anonymrobotic/artis/static/images/2-6.jpg

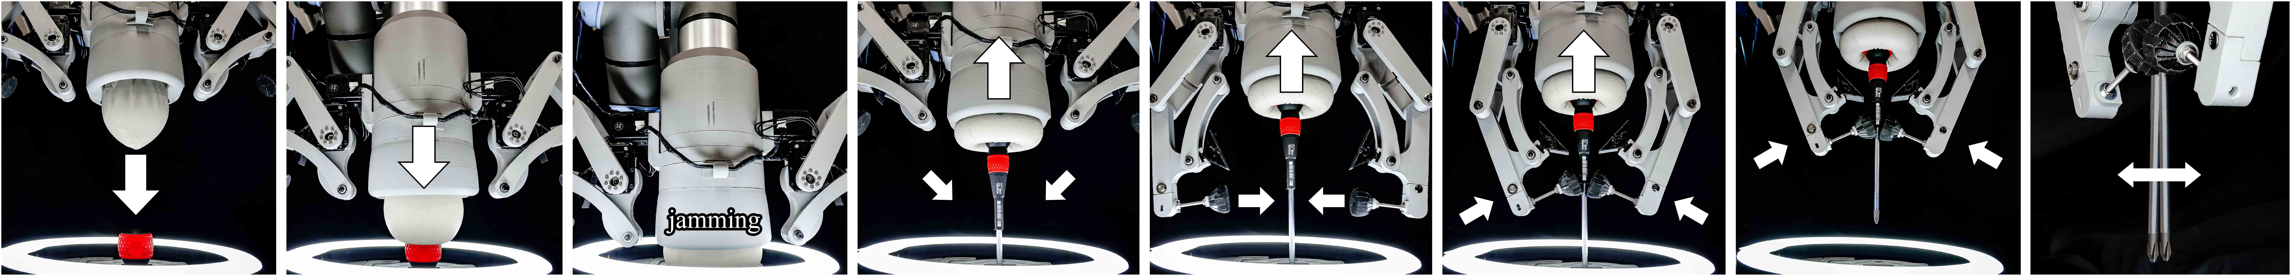
static/images/2-6.jpg
