anonymrobotic/artis/static/images/2F_1.jpg

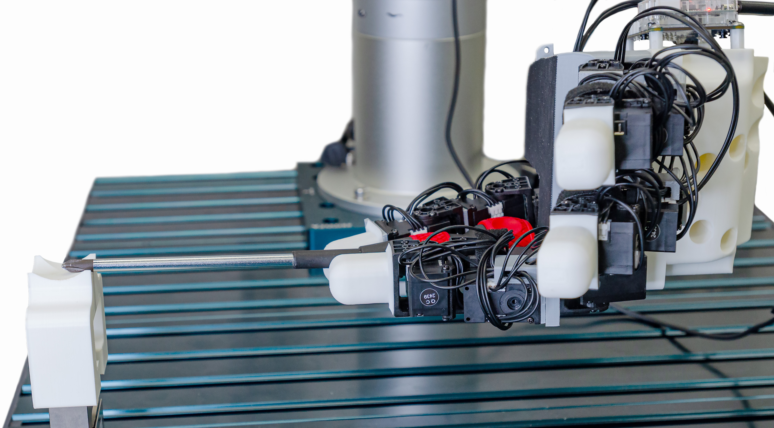
static/images/2F_1.jpg
