anonymrobotic/artis/static/images/3F_1.jpg

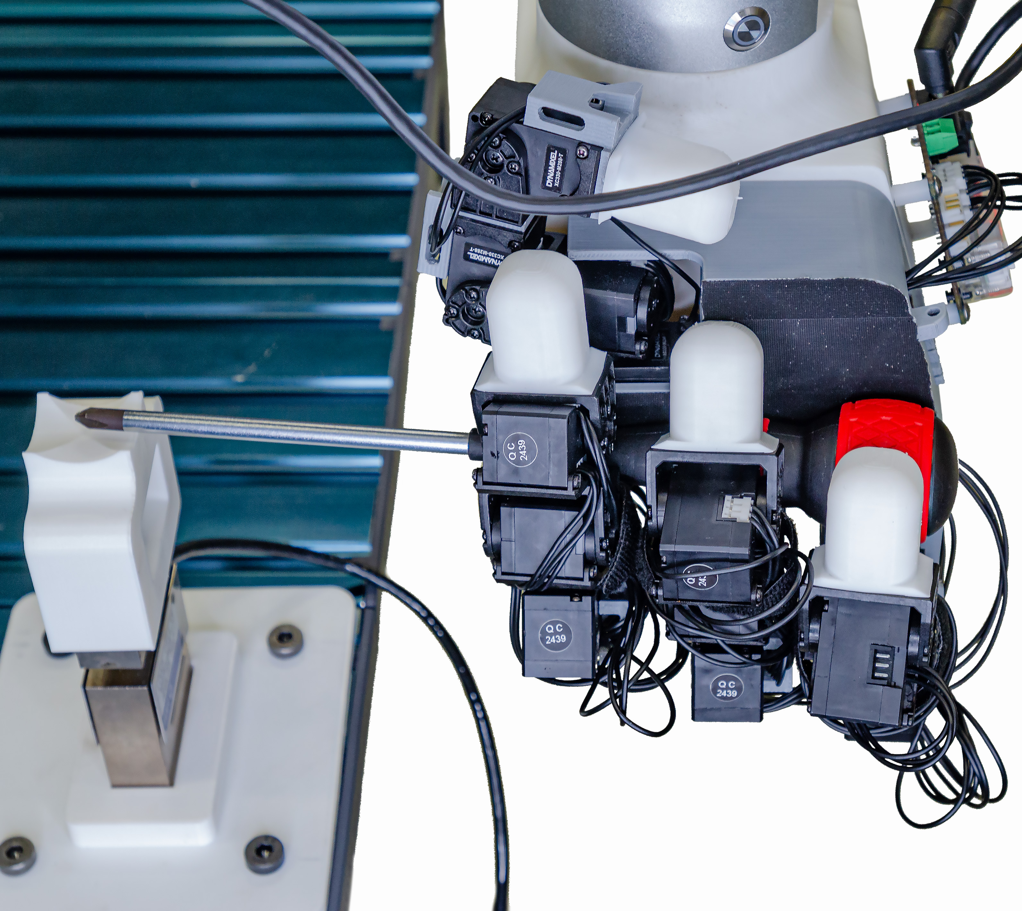
static/images/3F_1.jpg
