anonymrobotic/artis/static/images/Abstract_1.jpg

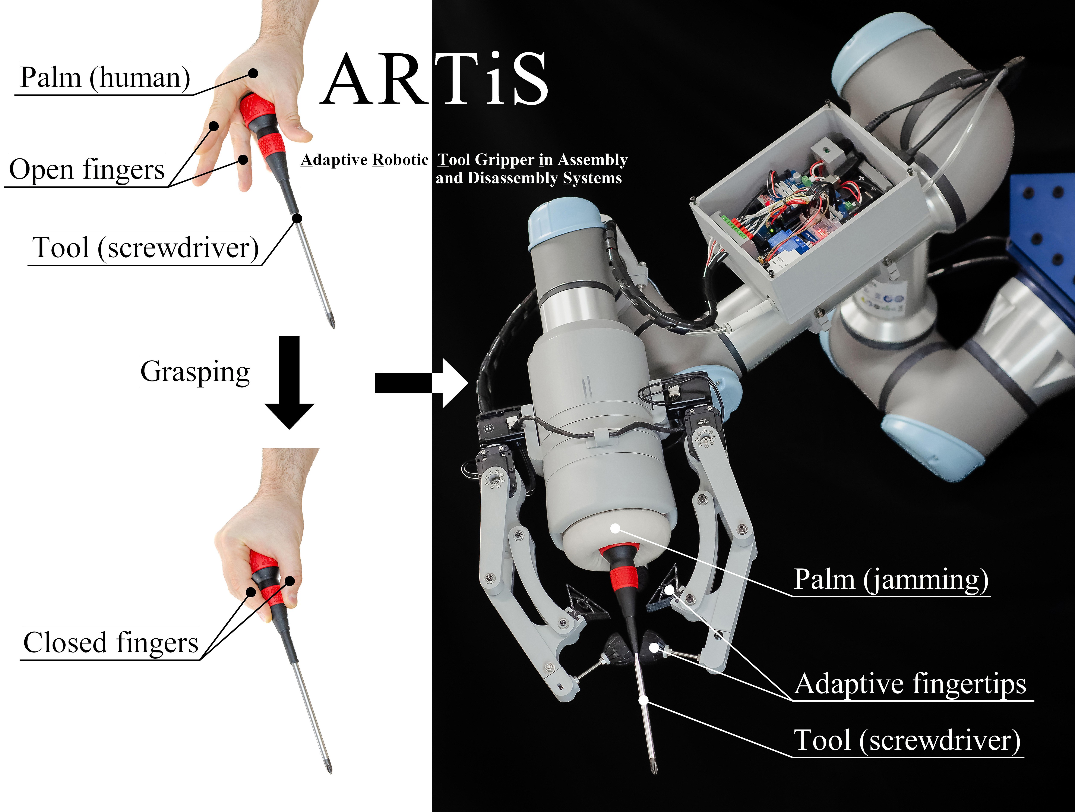
static/images/Abstract_1.jpg
