anonymrobotic/artis/static/images/AIST.jpg

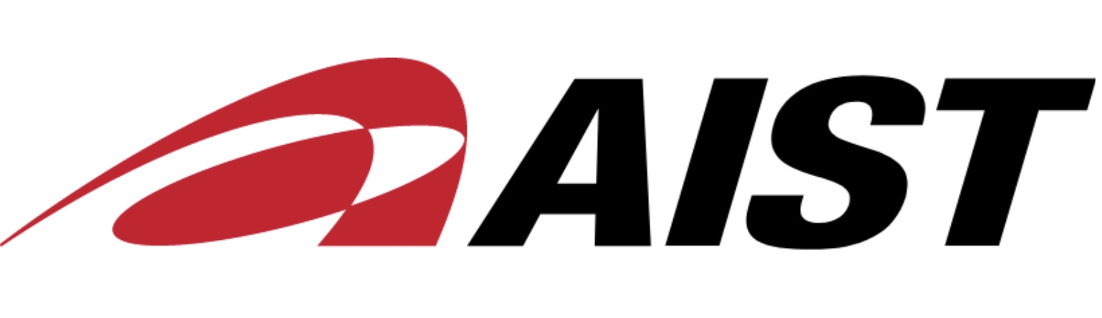
static/images/AIST.jpg
