anonymrobotic/artis/static/images/CAD/Axis_holder.jpg

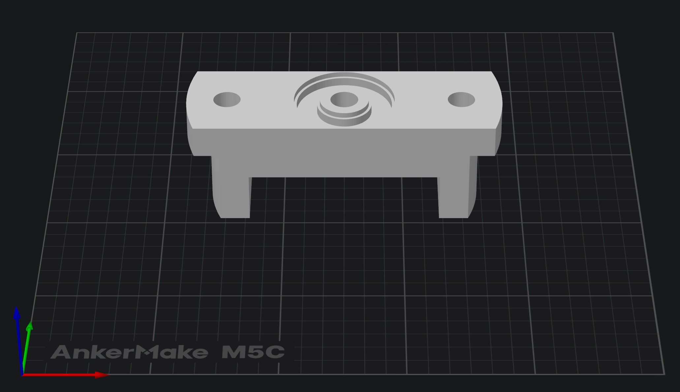
static/images/CAD/Axis_holder.jpg
