anonymrobotic/artis/static/images/CAD/Axle_lock.jpg

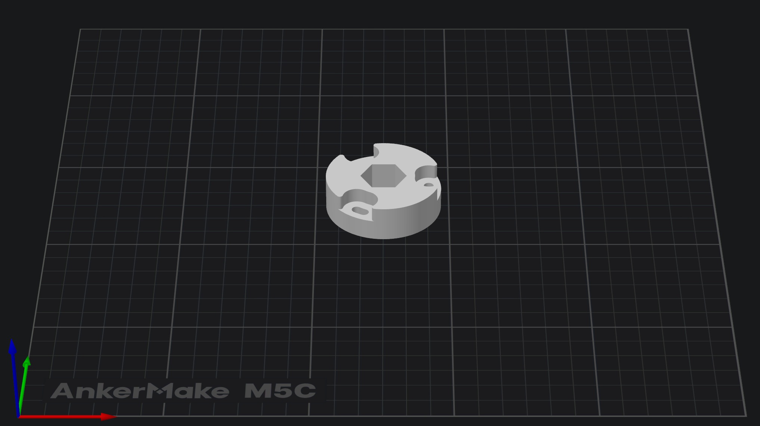
static/images/CAD/Axle_lock.jpg
