anonymrobotic/artis/static/images/CAD/Base1.jpg

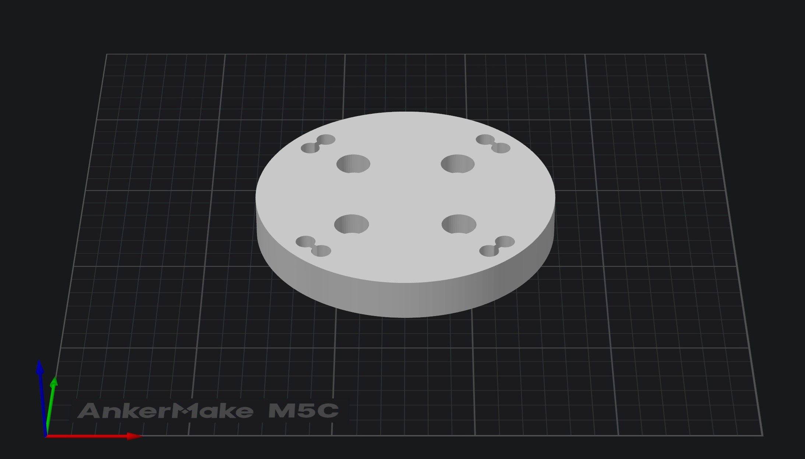
static/images/CAD/Base1.jpg
