anonymrobotic/artis/static/images/CAD/Base2.jpg

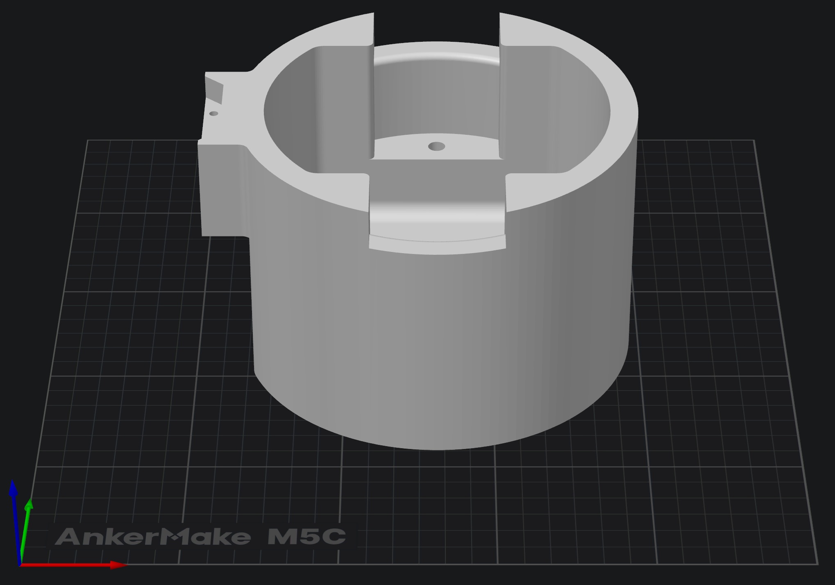
static/images/CAD/Base2.jpg
