anonymrobotic/artis/static/images/CAD/Box.jpg

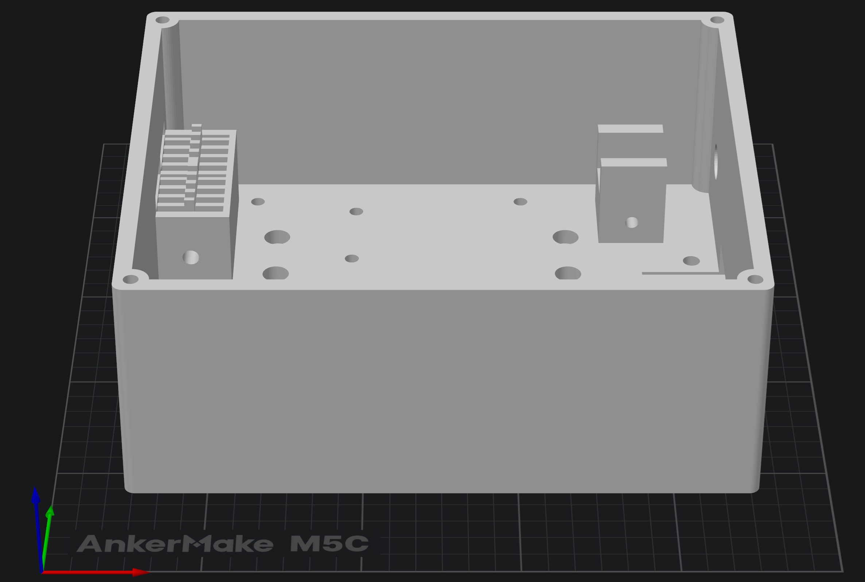
static/images/CAD/Box.jpg
