anonymrobotic/artis/static/images/CAD/Box_Holder.jpg

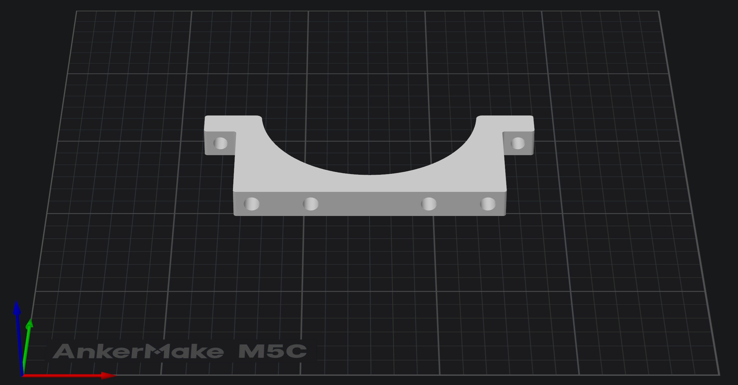
static/images/CAD/Box_Holder.jpg
