anonymrobotic/artis/static/images/CAD/Box_Holder_Bot.jpg

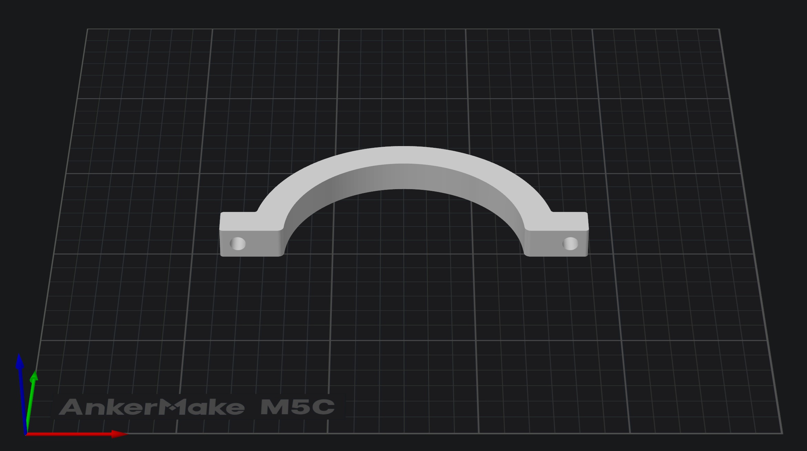
static/images/CAD/Box_Holder_Bot.jpg
