anonymrobotic/artis/static/images/CAD/Cable_retention.jpg

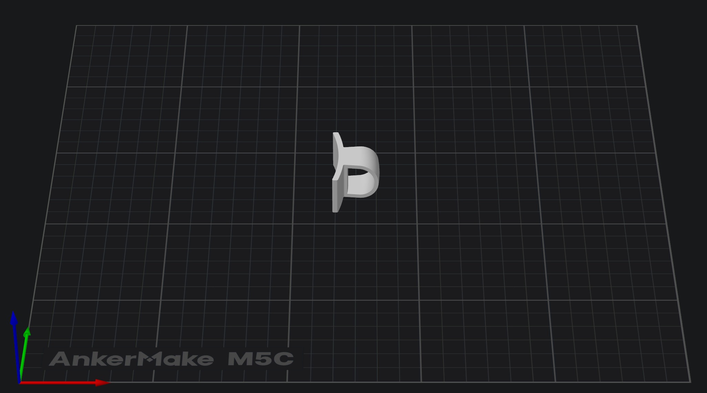
static/images/CAD/Cable_retention.jpg
