anonymrobotic/artis/static/images/CAD/Cup.jpg

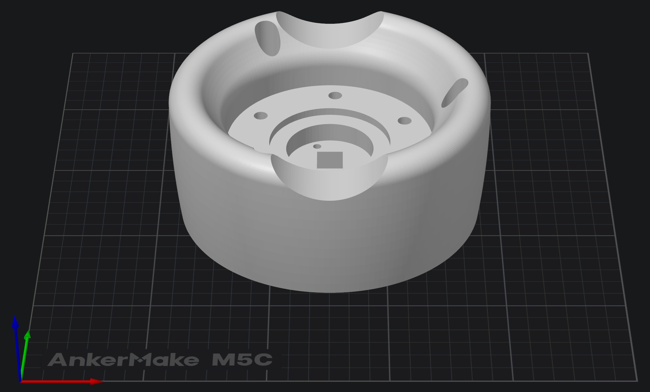
static/images/CAD/Cup.jpg
