anonymrobotic/artis/static/images/CAD/Fastener.jpg

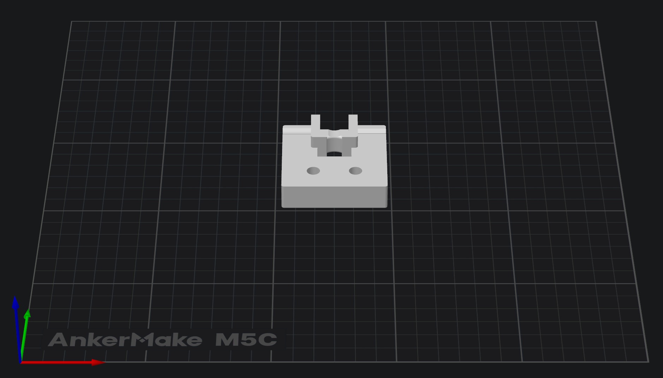
static/images/CAD/Fastener.jpg
