anonymrobotic/artis/static/images/CAD/Filter.jpg

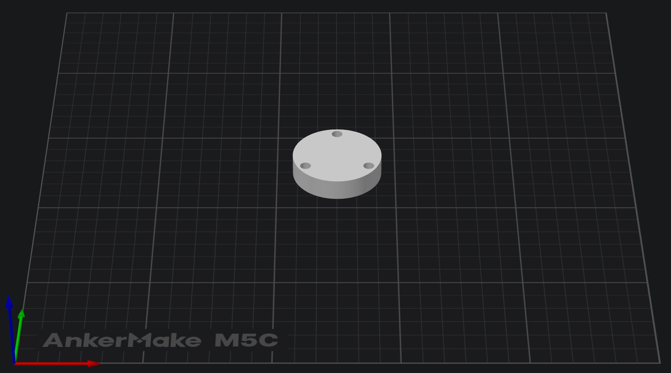
static/images/CAD/Filter.jpg
