anonymrobotic/artis/static/images/CAD/Gear.jpg

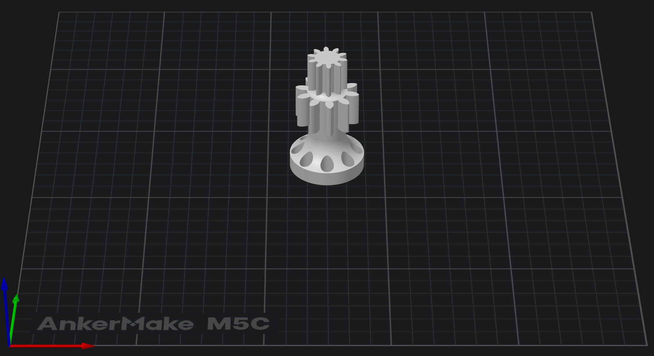
static/images/CAD/Gear.jpg
