anonymrobotic/artis/static/images/CAD/Jamming_holder.jpg

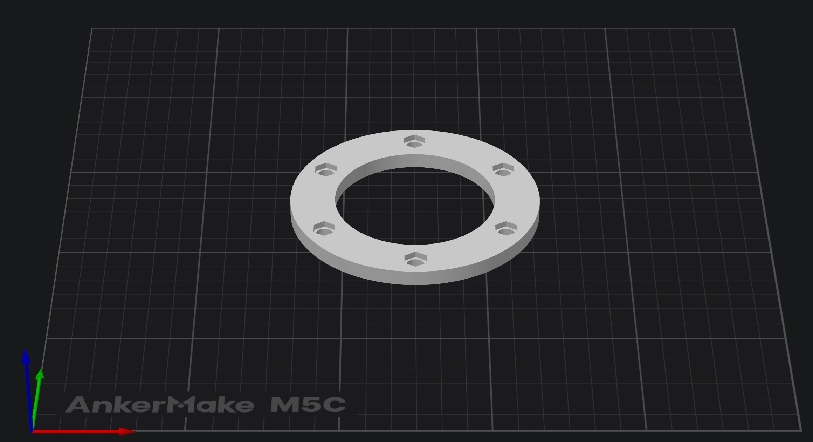
static/images/CAD/Jamming_holder.jpg
