anonymrobotic/artis/static/images/CAD/L0.jpg

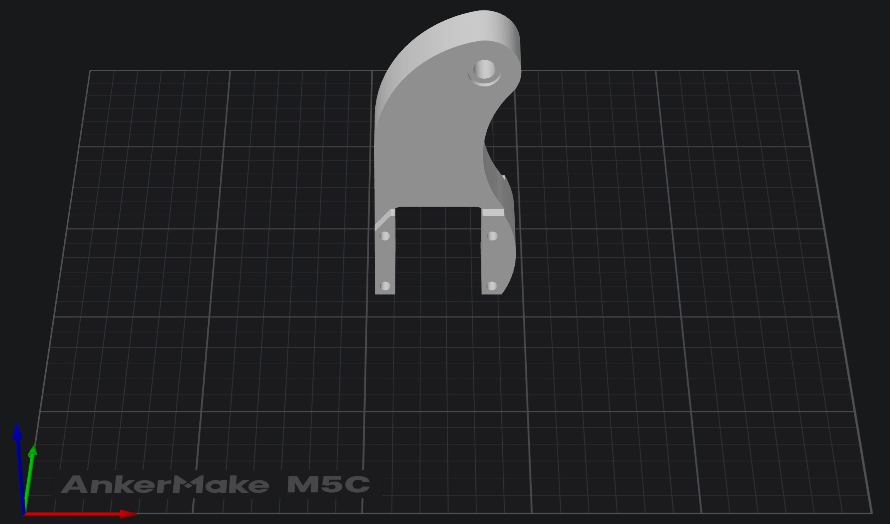
static/images/CAD/L0.jpg
