anonymrobotic/artis/static/images/CAD/L1.jpg

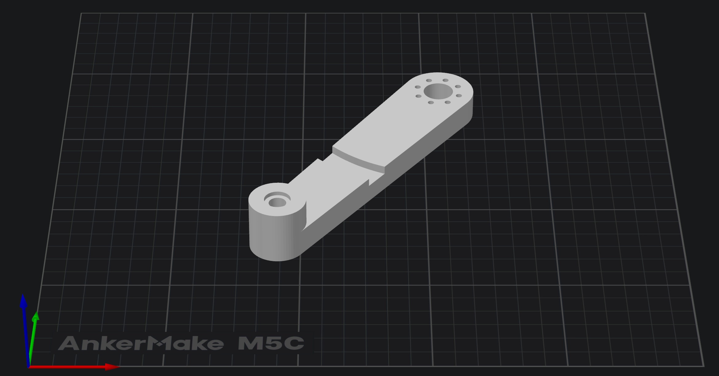
static/images/CAD/L1.jpg
