anonymrobotic/artis/static/images/CAD/L3.jpg

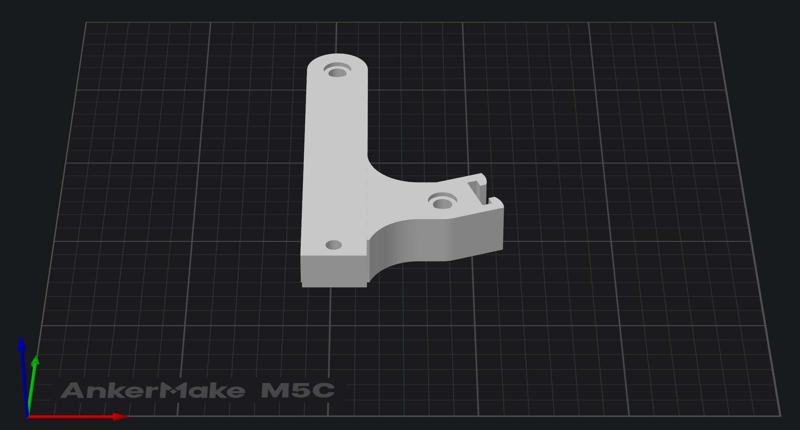
static/images/CAD/L3.jpg
