anonymrobotic/artis/static/images/CAD/Power_supply_holder.jpg

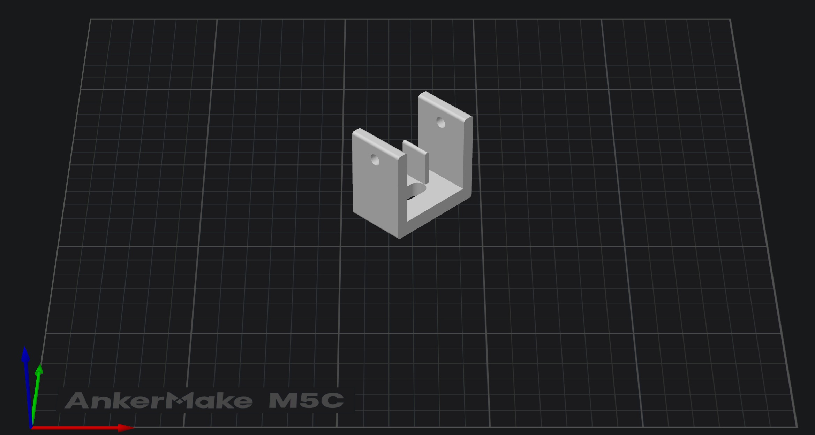
static/images/CAD/Power_supply_holder.jpg
