anonymrobotic/artis/static/images/CAD/Pre_tip.jpg

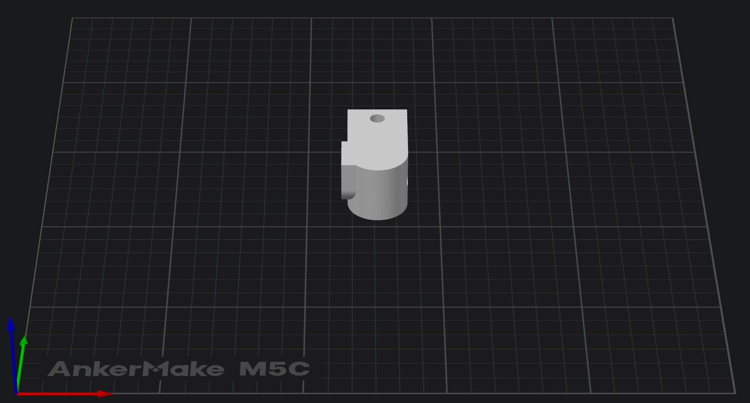
static/images/CAD/Pre_tip.jpg
