anonymrobotic/artis/static/images/CAD/Robot_cable_holder.jpg

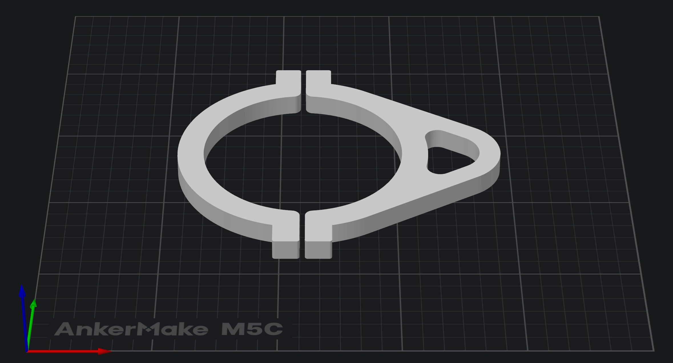
static/images/CAD/Robot_cable_holder.jpg
