anonymrobotic/artis/static/images/CAD/Rotating_Platform_1.jpg

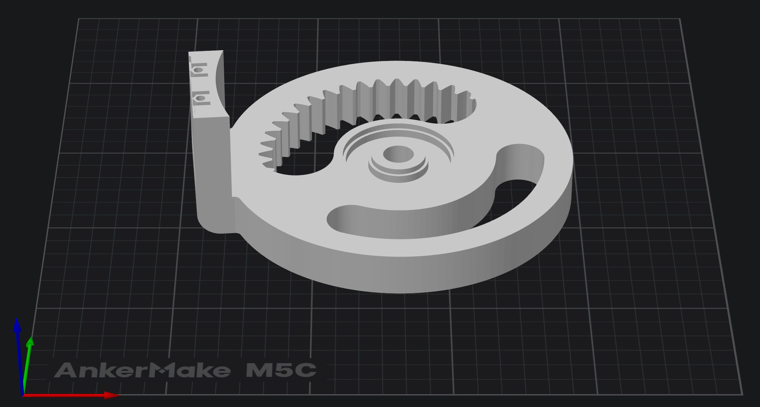
static/images/CAD/Rotating_Platform_1.jpg
