anonymrobotic/artis/static/images/CAD/Rotating_Platform_2.jpg

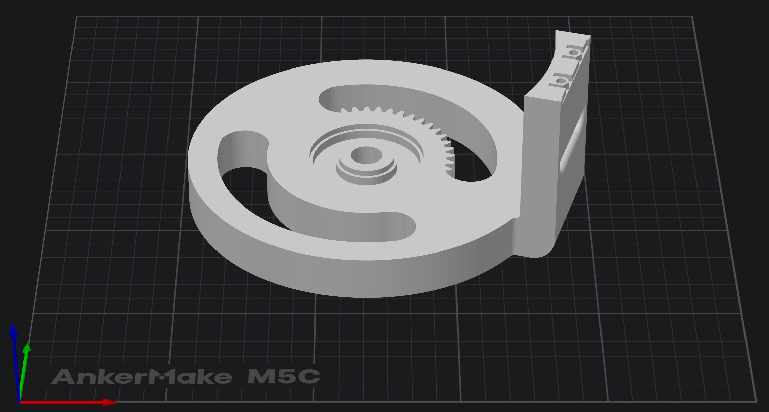
static/images/CAD/Rotating_Platform_2.jpg
