anonymrobotic/artis/static/images/CAD/TIP1.jpg

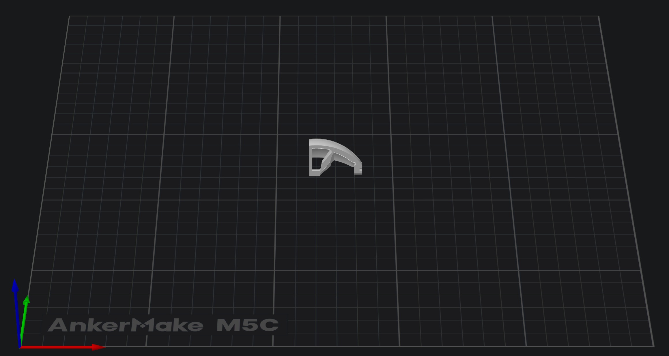
static/images/CAD/TIP1.jpg
