anonymrobotic/artis/static/images/CAD/TIP1_holder.jpg

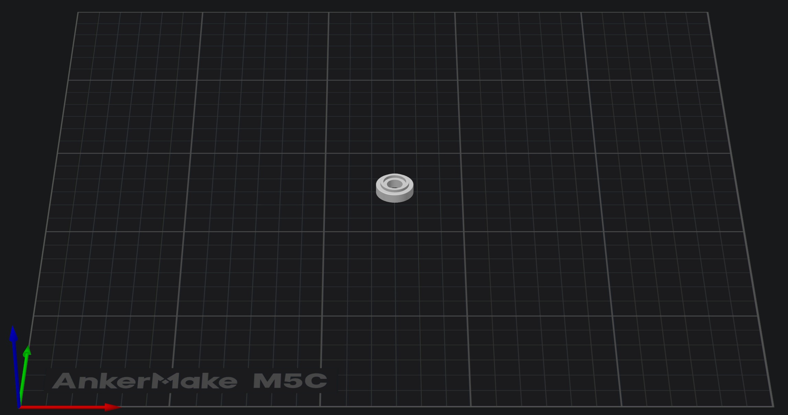
static/images/CAD/TIP1_holder.jpg
