anonymrobotic/artis/static/images/CAD/Tool_holder_1.jpg

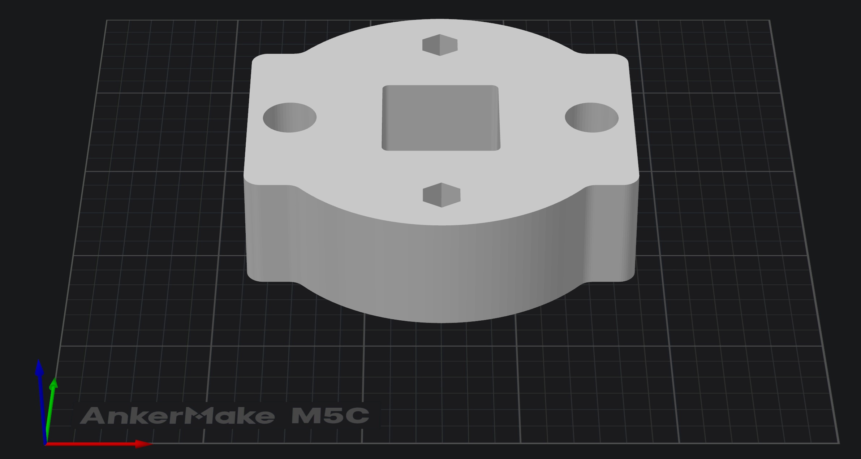
static/images/CAD/Tool_holder_1.jpg
