anonymrobotic/artis/static/images/CAD/Tool_holder_2.jpg

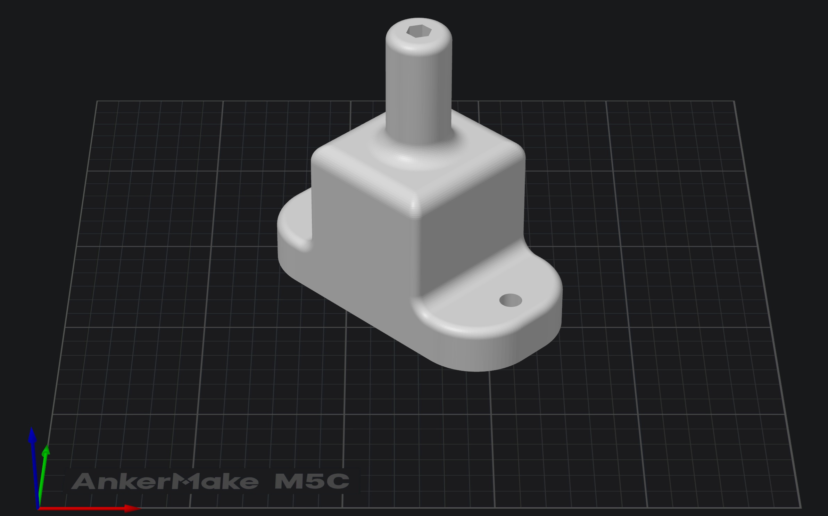
static/images/CAD/Tool_holder_2.jpg
