anonymrobotic/artis/static/images/CAD/Tool_holder_3.jpg

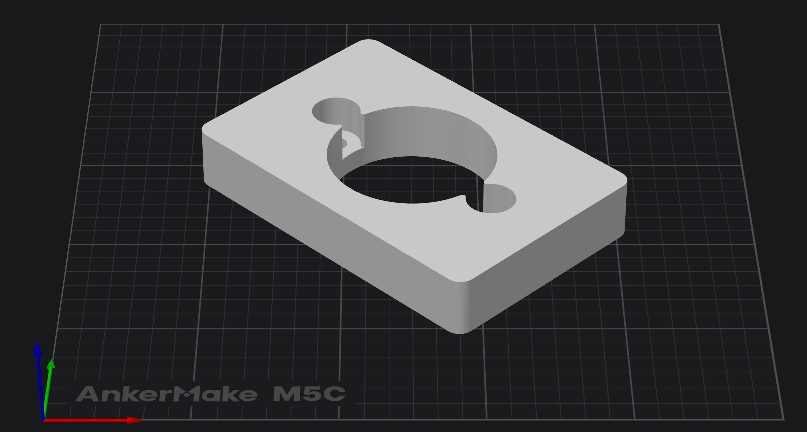
static/images/CAD/Tool_holder_3.jpg
