anonymrobotic/artis/static/images/CAD/Top_axis_holder.jpg

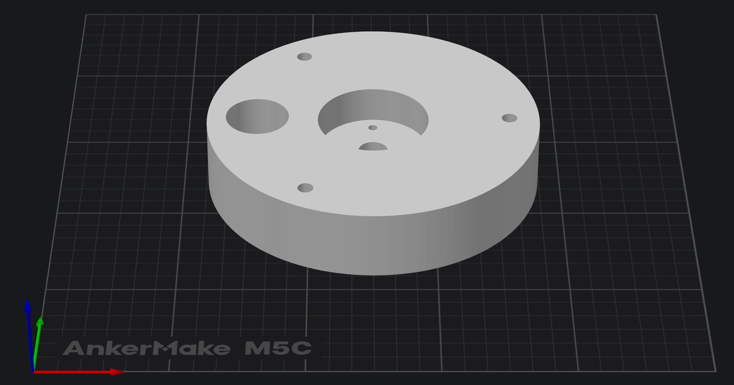
static/images/CAD/Top_axis_holder.jpg
