anonymrobotic/artis/static/images/CAD/Tube_holder.jpg

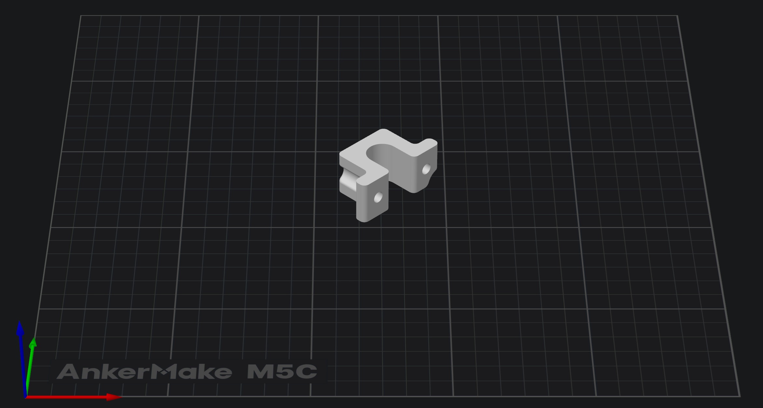
static/images/CAD/Tube_holder.jpg
