anonymrobotic/artis/static/images/CAD/USB_holder.jpg

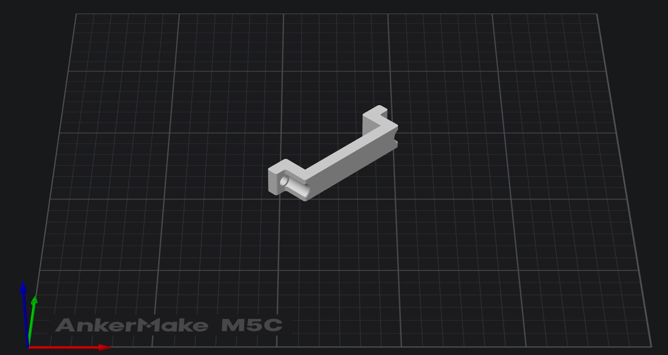
static/images/CAD/USB_holder.jpg
