anonymrobotic/artis/static/images/CAD_Design1.jpg

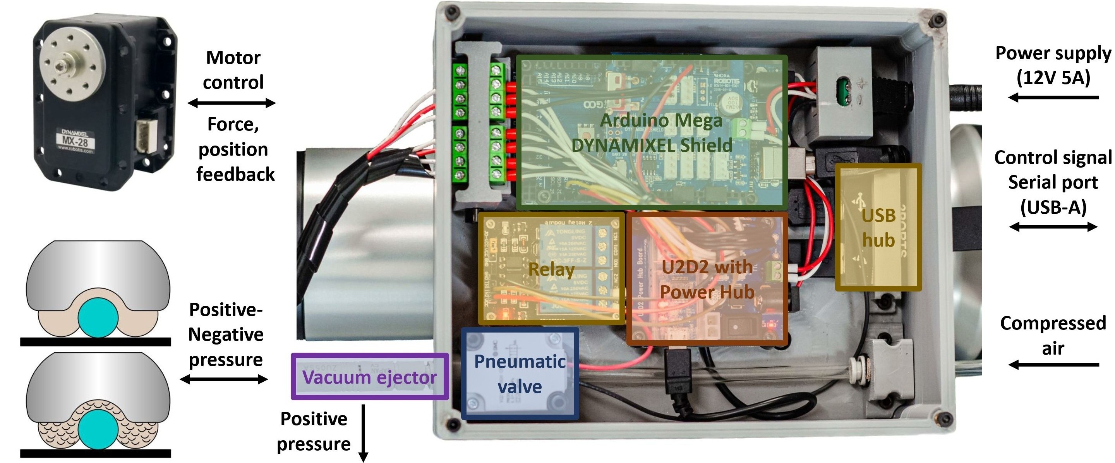
static/images/CAD_Design1.jpg
