anonymrobotic/artis/static/images/Denso.png

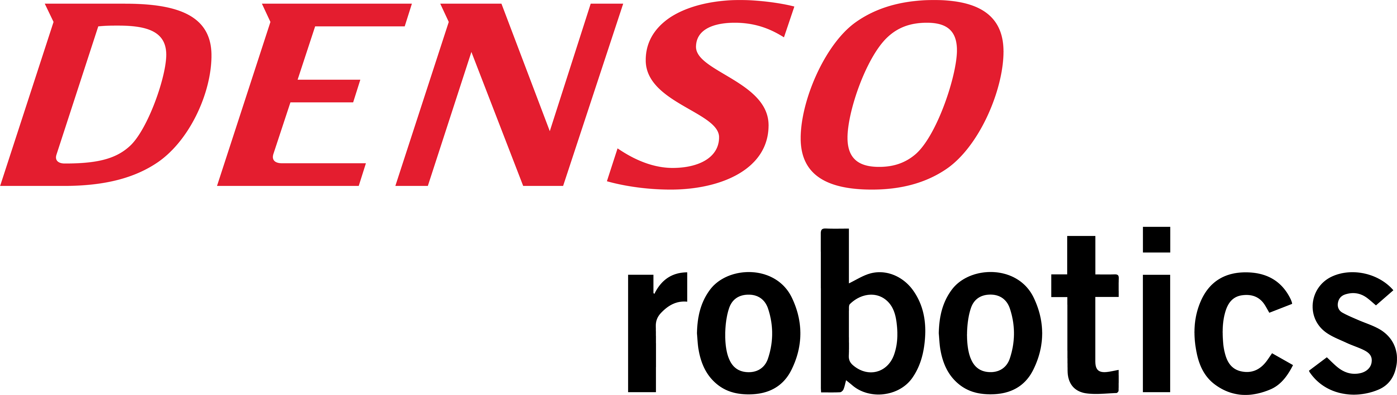
static/images/Denso.png
