anonymrobotic/artis/static/images/dreel.jpg

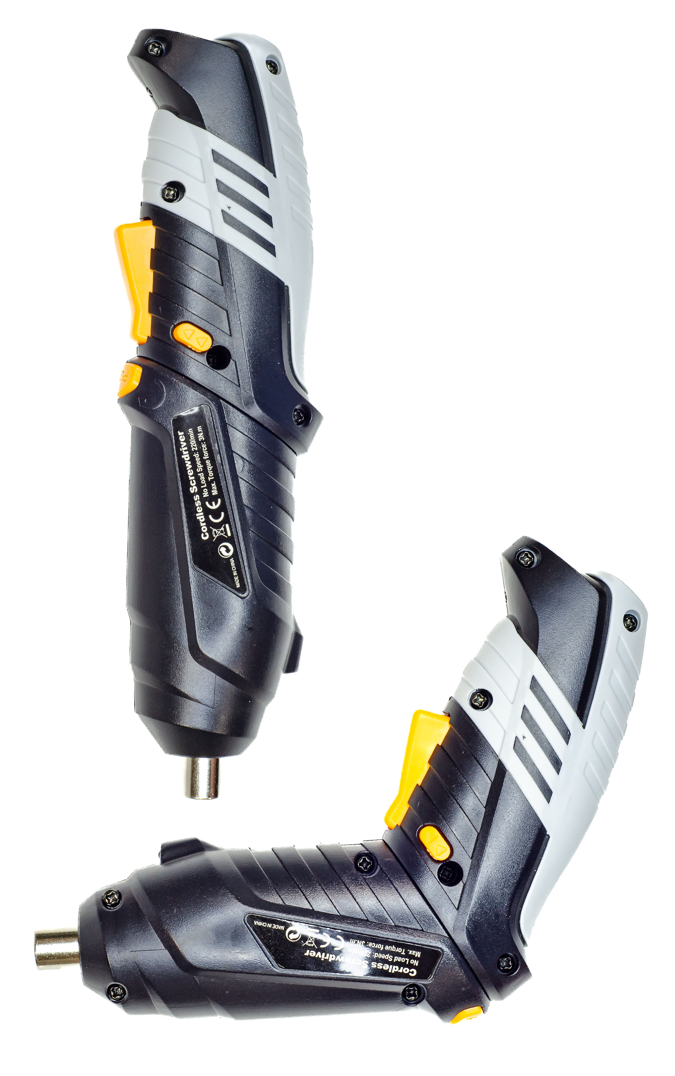
static/images/dreel.jpg
