anonymrobotic/artis/static/images/dreel_1.jpg

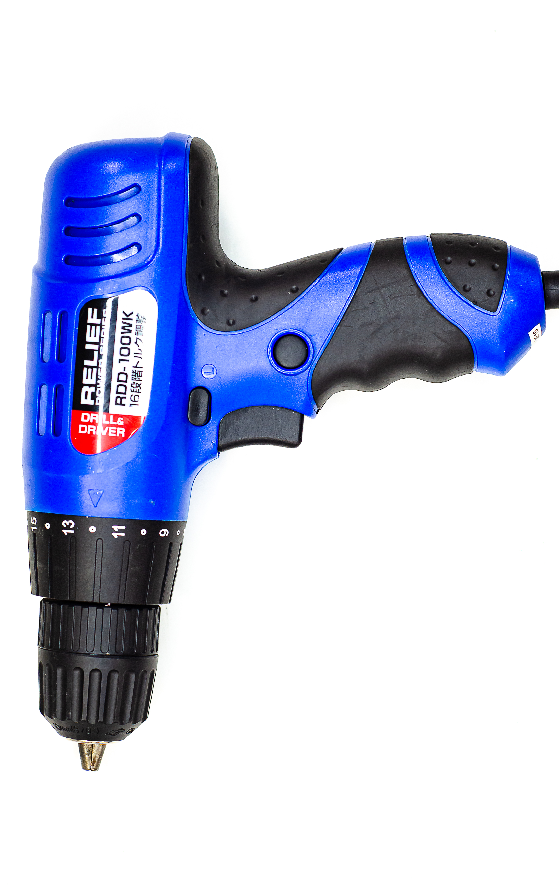
static/images/dreel_1.jpg
