anonymrobotic/artis/static/images/dreel_2.jpg

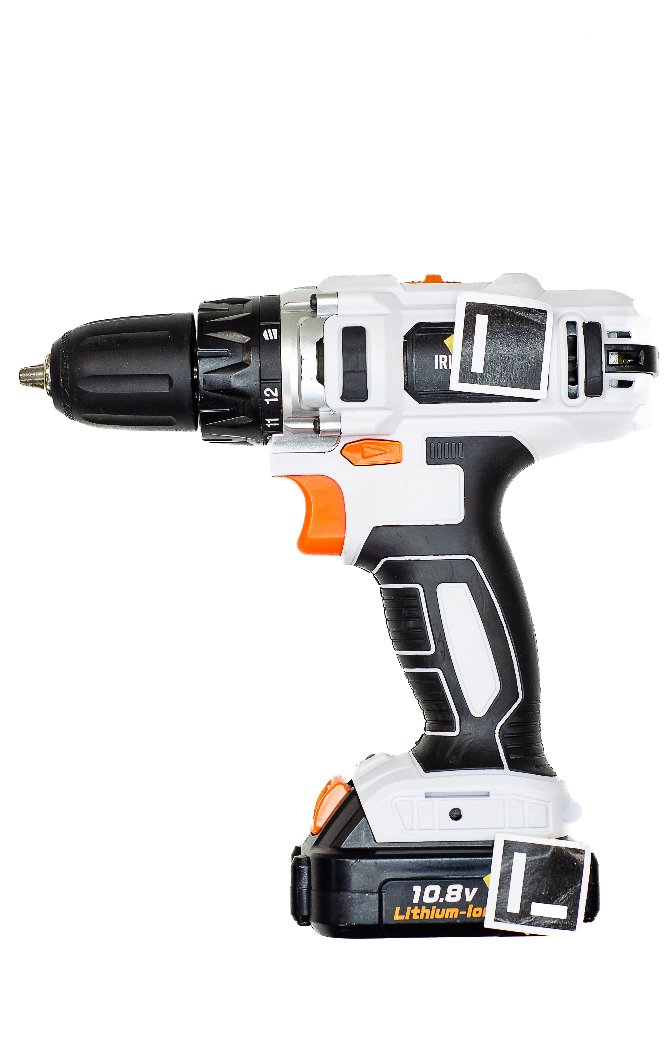
static/images/dreel_2.jpg
