anonymrobotic/artis/static/images/F_br.jpg

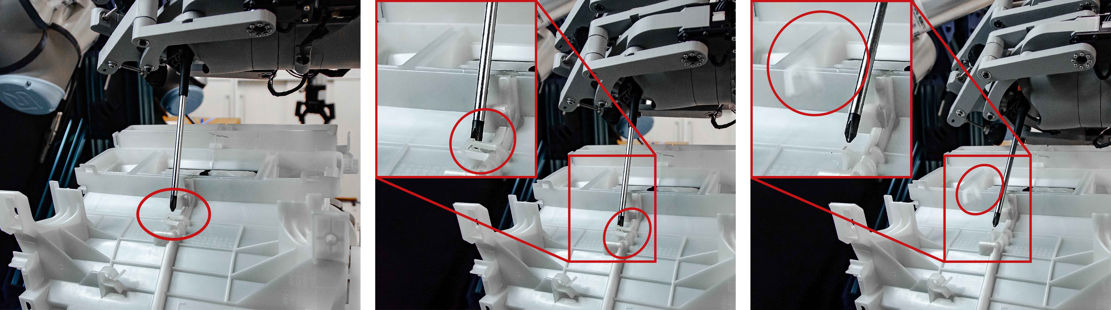
static/images/F_br.jpg
