anonymrobotic/artis/static/images/F_ham.jpg

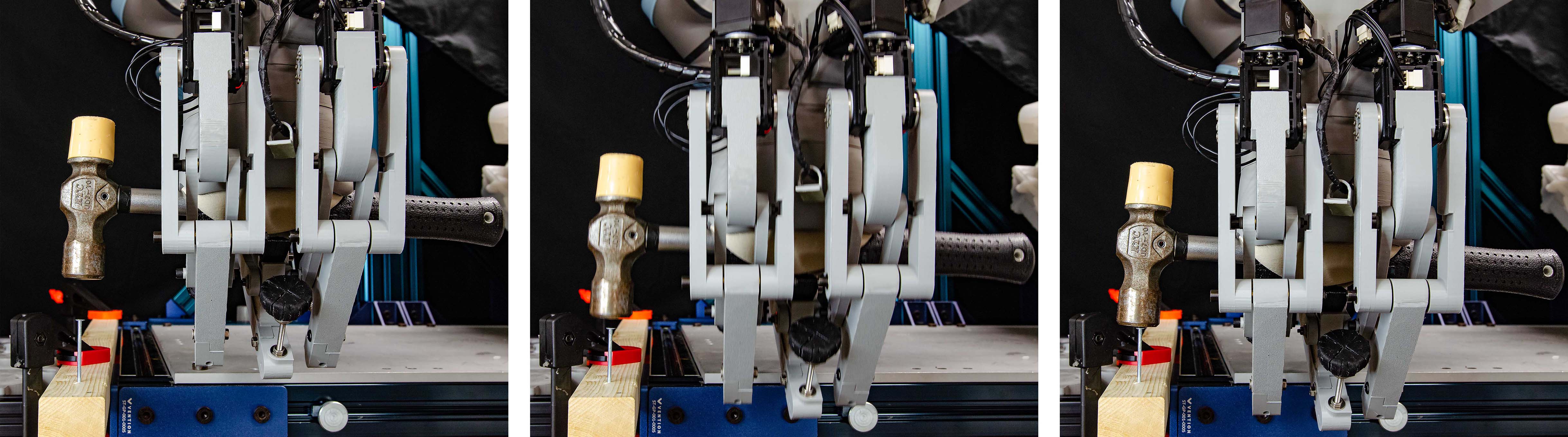
static/images/F_ham.jpg
