anonymrobotic/artis/static/images/F_ham_1.jpg

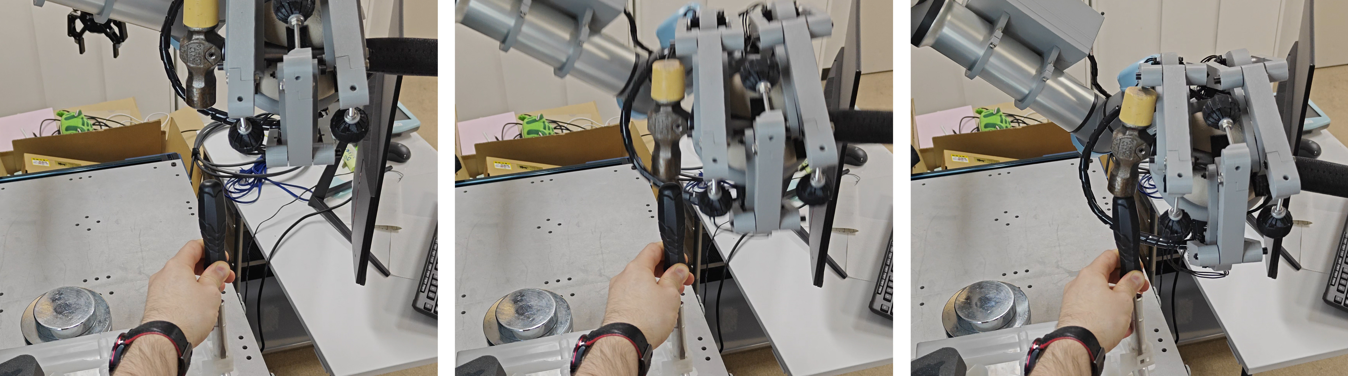
static/images/F_ham_1.jpg
