anonymrobotic/artis/static/images/Fig3_1_2.jpg

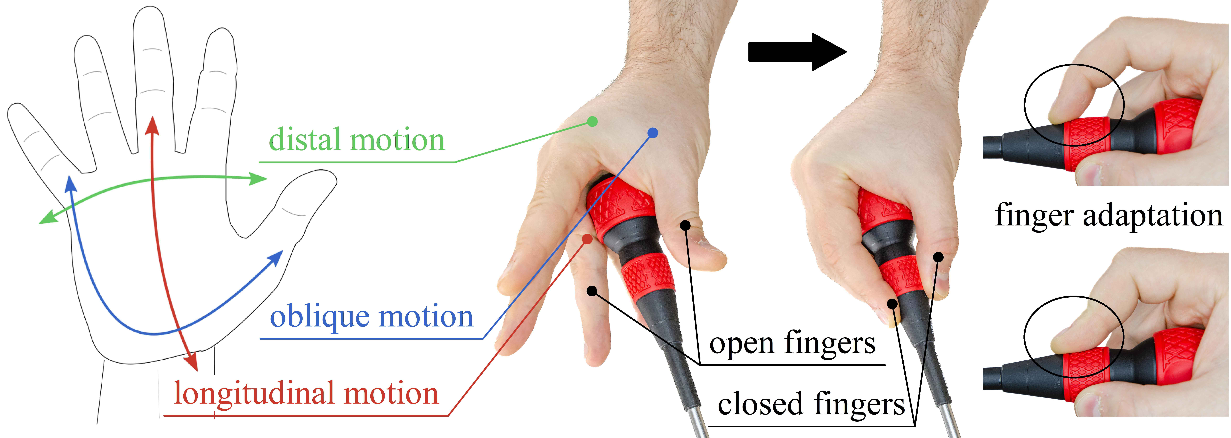
static/images/Fig3_1_2.jpg
