anonymrobotic/artis/static/images/Fig_4_2_5.jpg

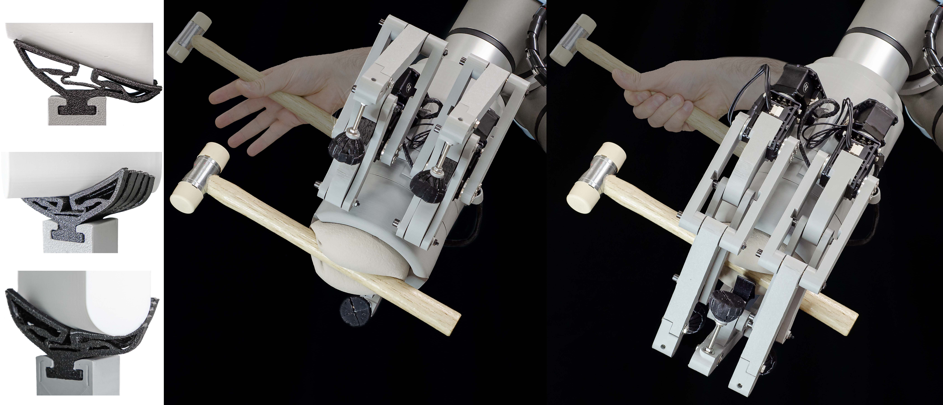
static/images/Fig_4_2_5.jpg
