anonymrobotic/artis/static/images/Fig_all_1.jpg

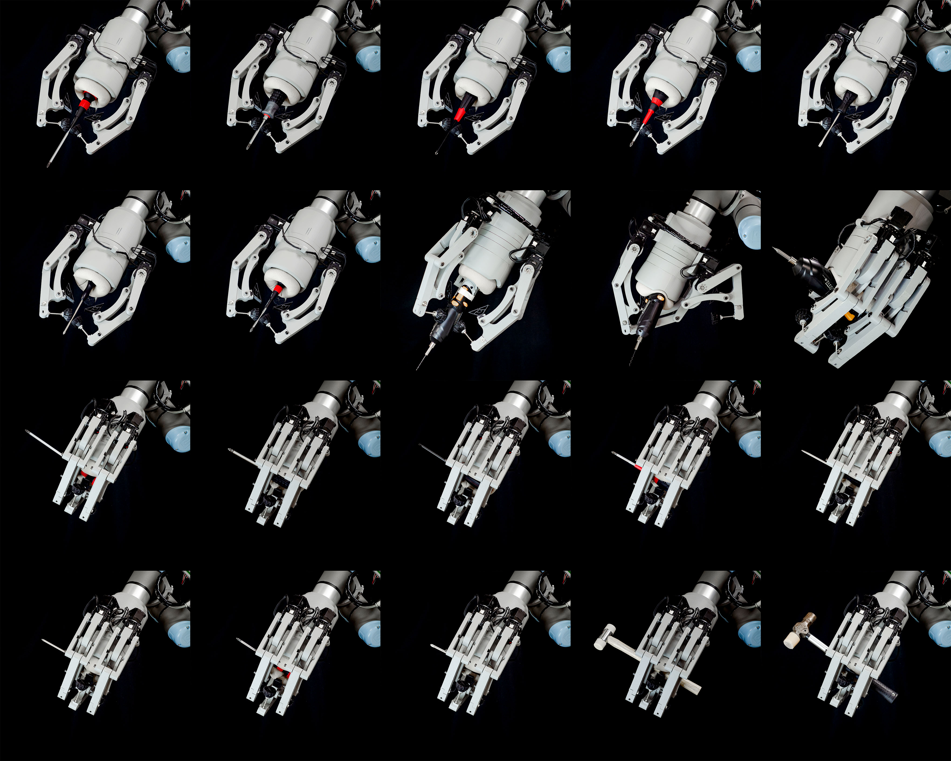
static/images/Fig_all_1.jpg
