anonymrobotic/artis/static/images/hammer_1_1.jpg

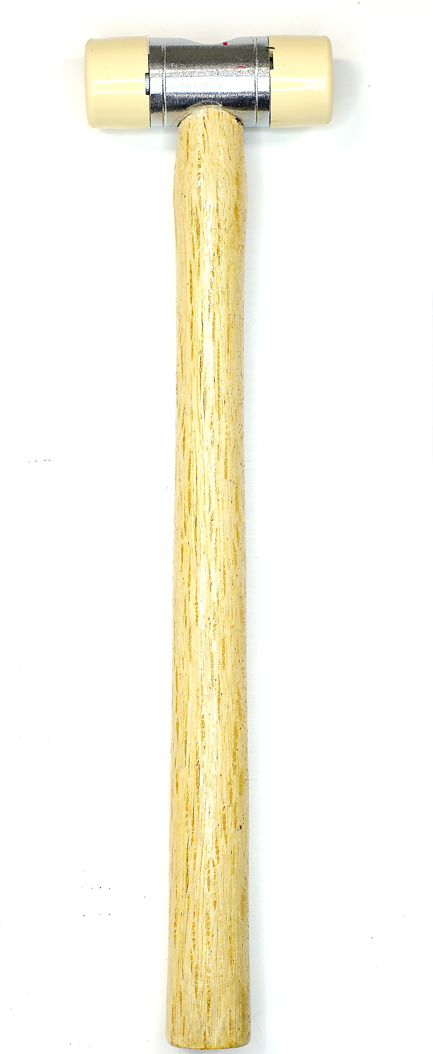
static/images/hammer_1_1.jpg
