anonymrobotic/artis/static/images/hammer_2.jpg

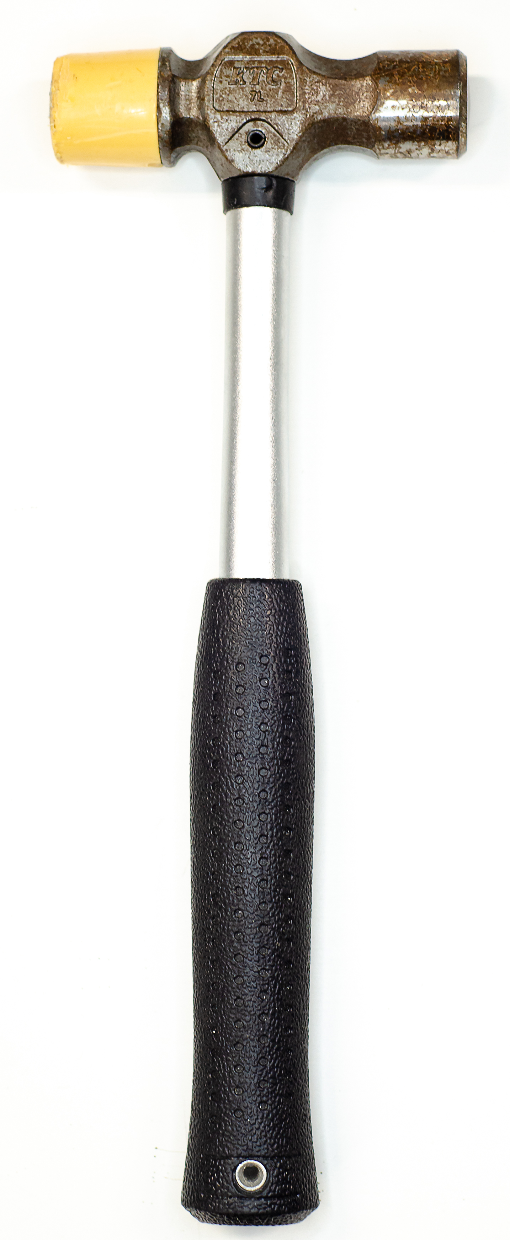
static/images/hammer_2.jpg
