anonymrobotic/artis/static/images/kinematic4.png

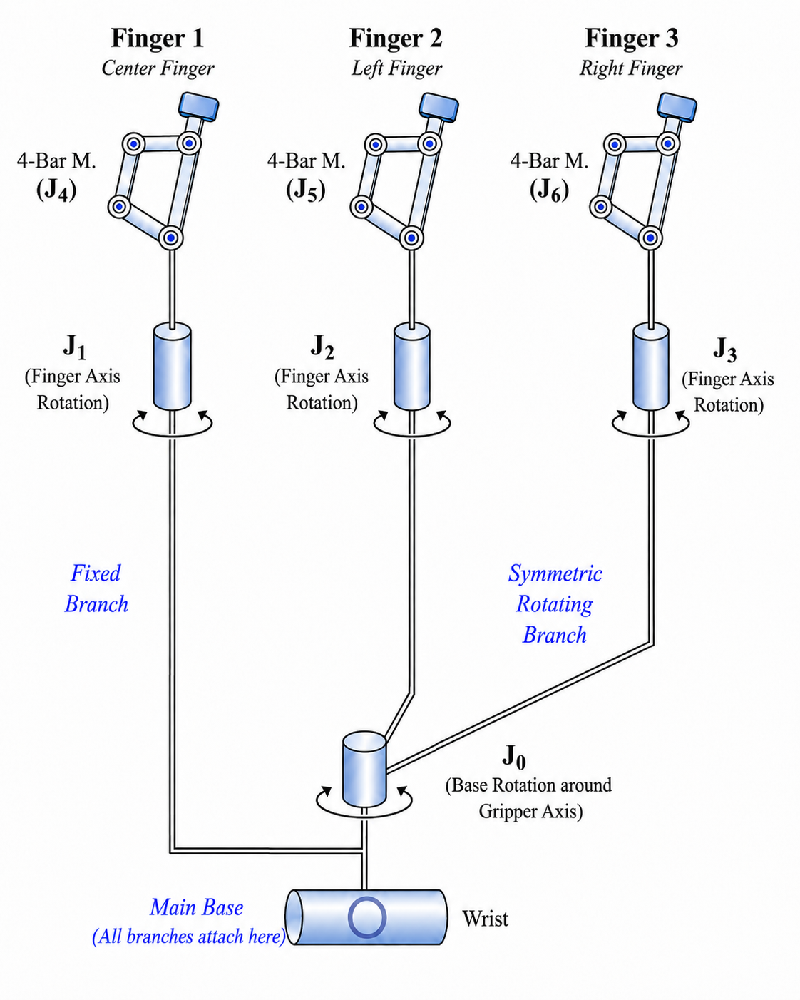
static/images/kinematic4.png
