anonymrobotic/artis/static/images/P_list/Arduino_Mega_2560.jpg

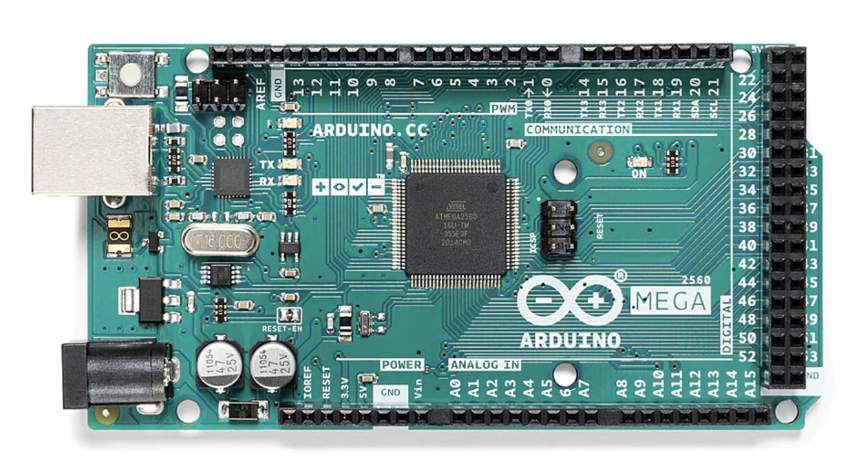
static/images/P_list/Arduino_Mega_2560.jpg
