anonymrobotic/artis/static/images/P_list/DXL_Starter_Set.jpg

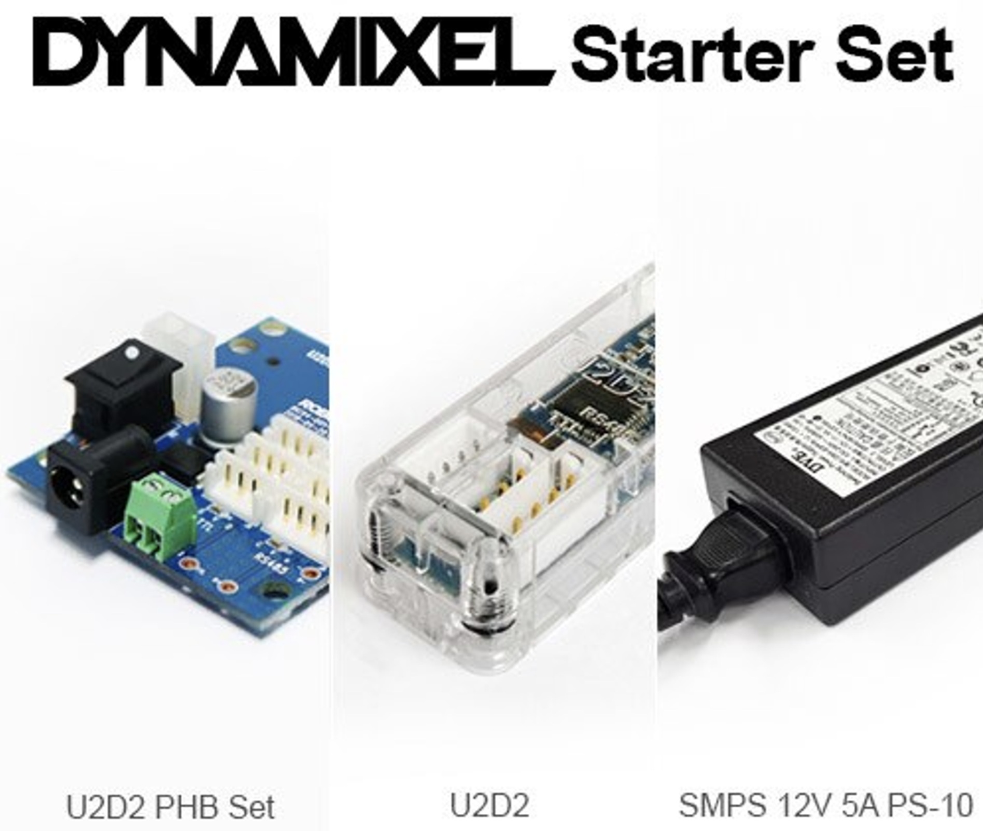
static/images/P_list/DXL_Starter_Set.jpg
