anonymrobotic/artis/static/images/P_list/DXLSHIELD.jpg

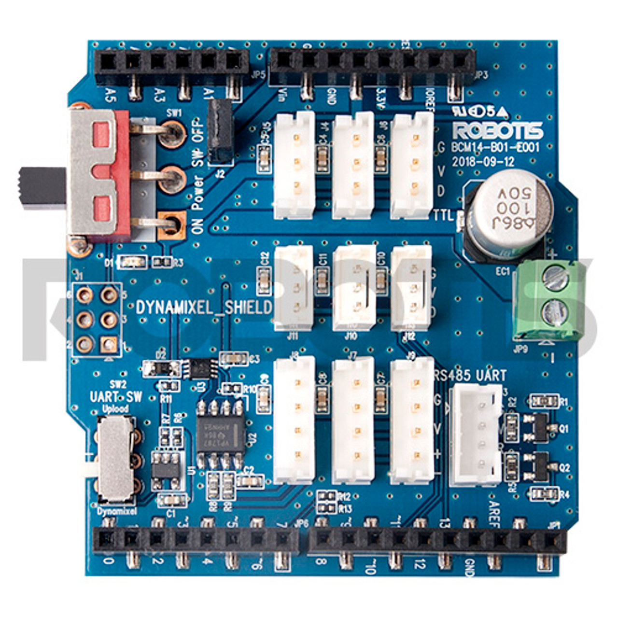
static/images/P_list/DXLSHIELD.jpg
