anonymrobotic/artis/static/images/P_list/ejector.jpg

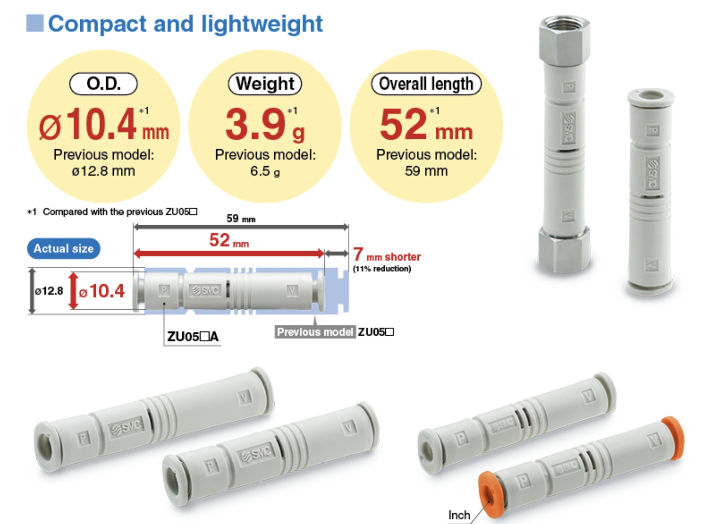
static/images/P_list/ejector.jpg
