anonymrobotic/artis/static/images/P_list/FR07_S101K_set.jpg

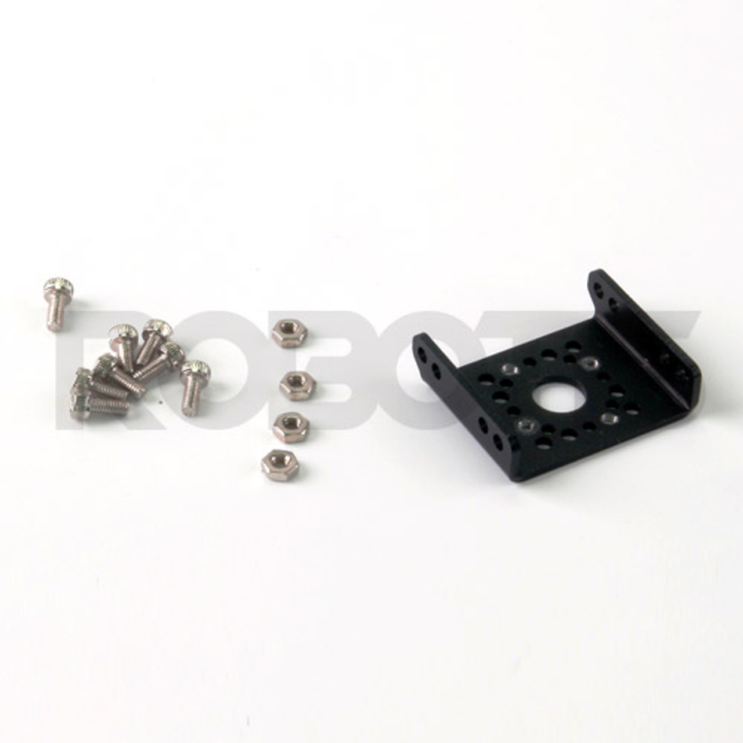
static/images/P_list/FR07_S101K_set.jpg
