anonymrobotic/artis/static/images/P_list/MX_28R.jpg

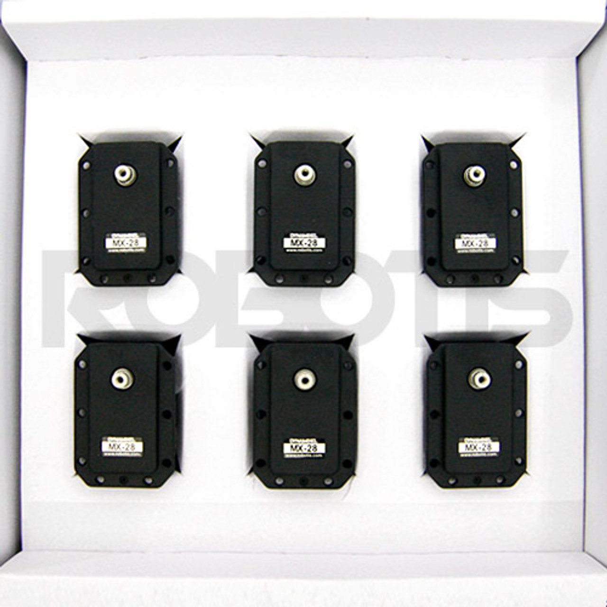
static/images/P_list/MX_28R.jpg
