anonymrobotic/artis/static/images/P_list/MX_64R.jpg

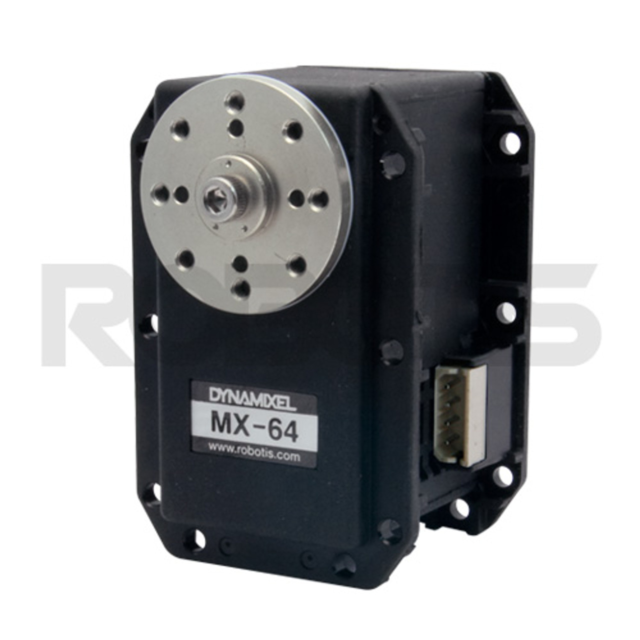
static/images/P_list/MX_64R.jpg
