anonymrobotic/artis/static/images/P_list/relay.jpg

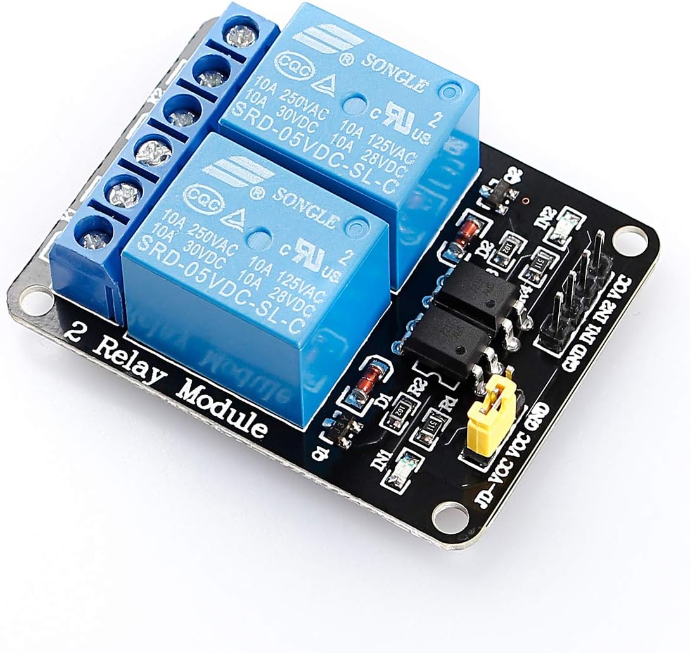
static/images/P_list/relay.jpg
