anonymrobotic/artis/static/images/P_list/valve.jpg

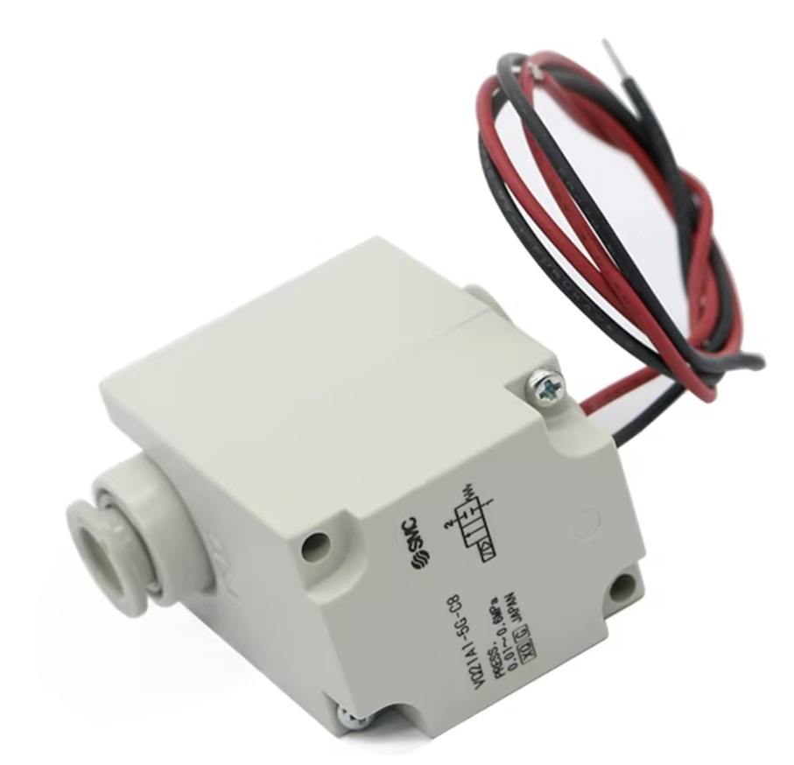
static/images/P_list/valve.jpg
