anonymrobotic/artis/static/images/r1.jpg

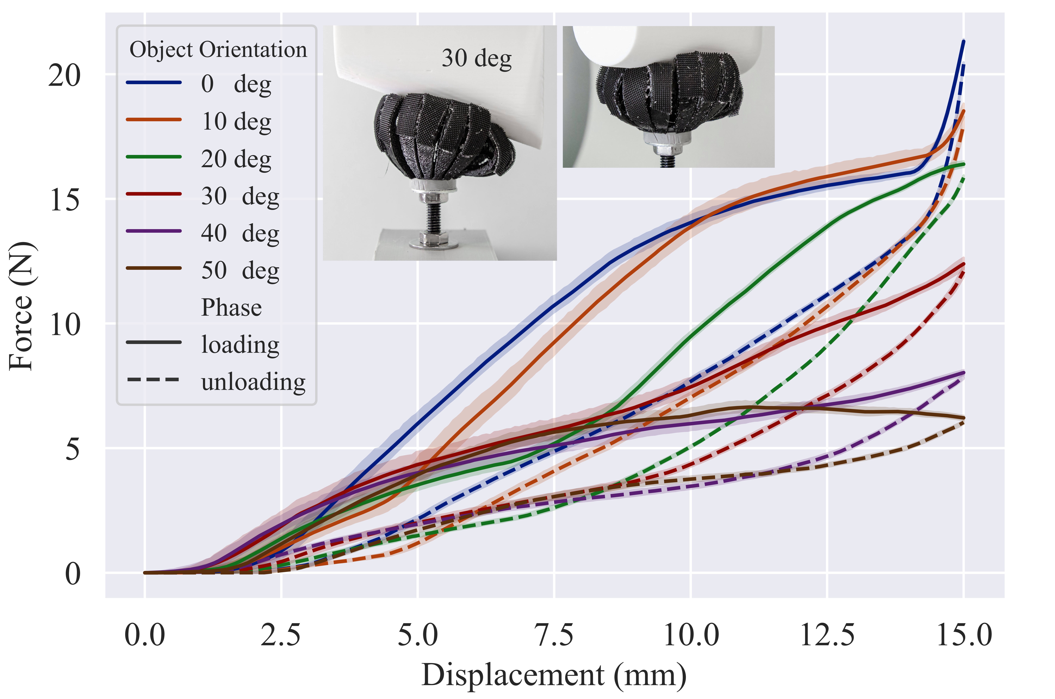
static/images/r1.jpg
