anonymrobotic/artis/static/images/r2.jpg

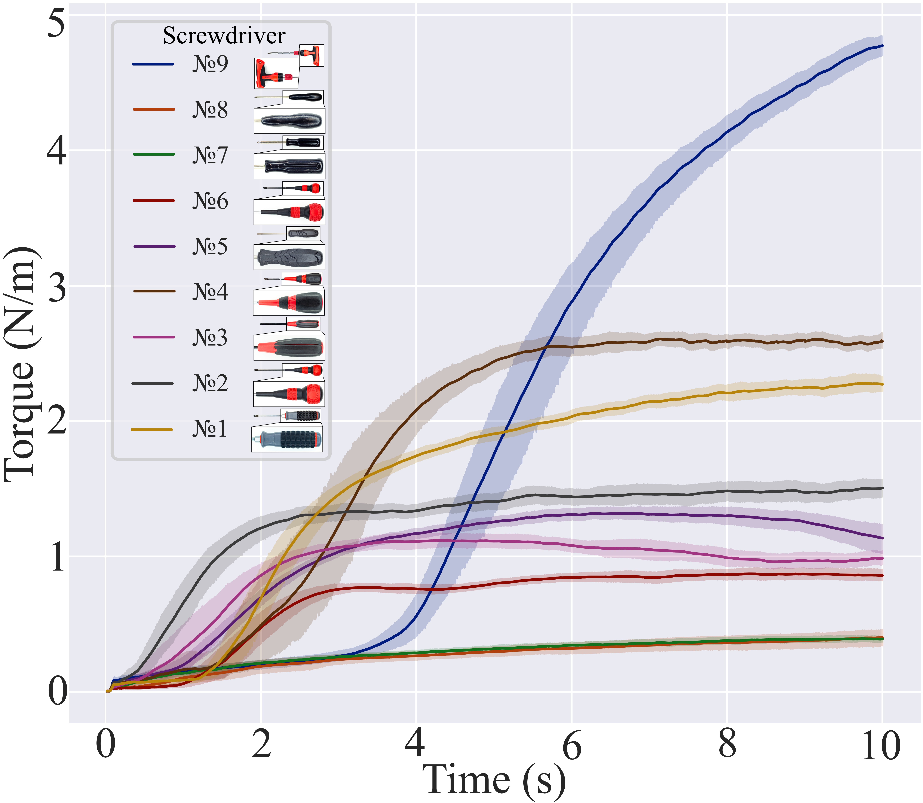
static/images/r2.jpg
