anonymrobotic/artis/static/images/r3.jpg

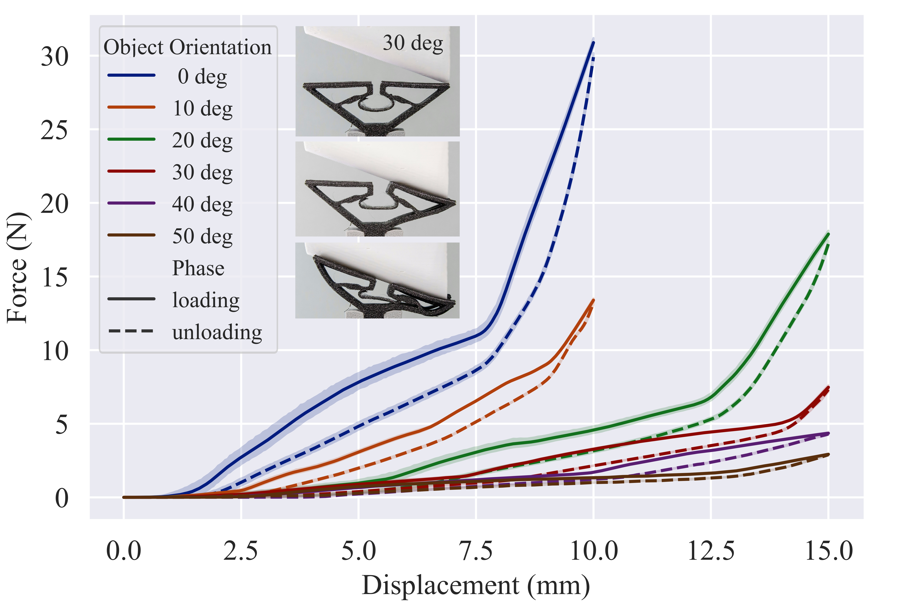
static/images/r3.jpg
