anonymrobotic/artis/static/images/r4.jpg

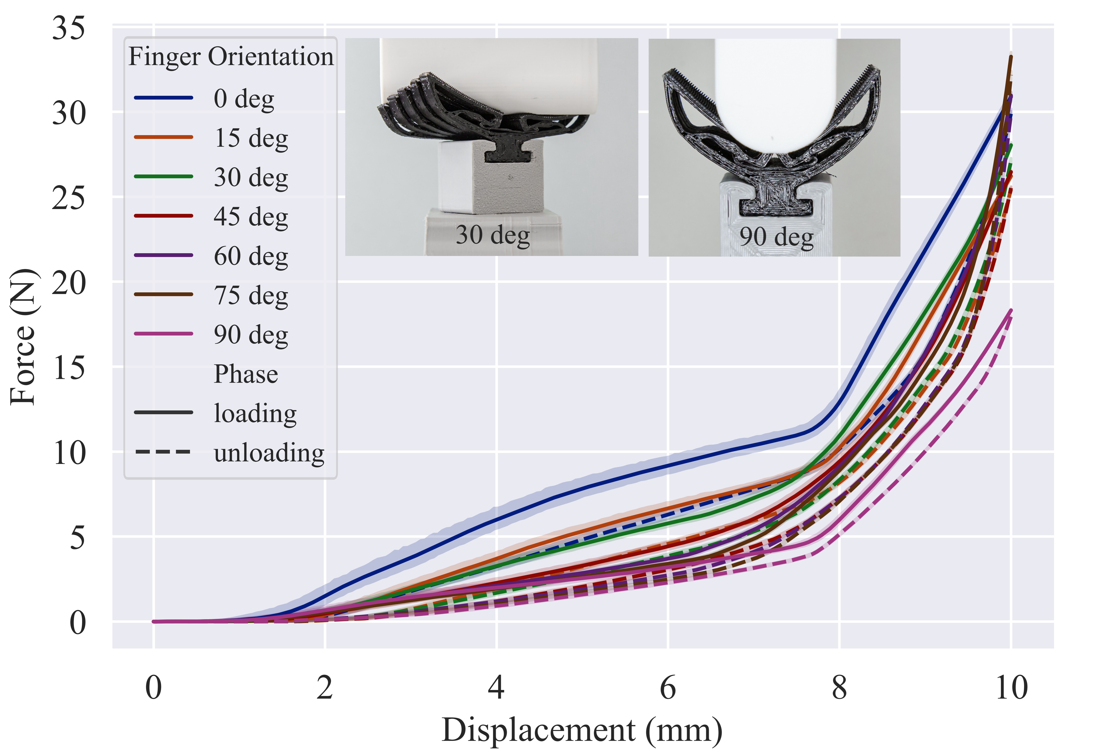
static/images/r4.jpg
