anonymrobotic/artis/static/images/r5.jpg

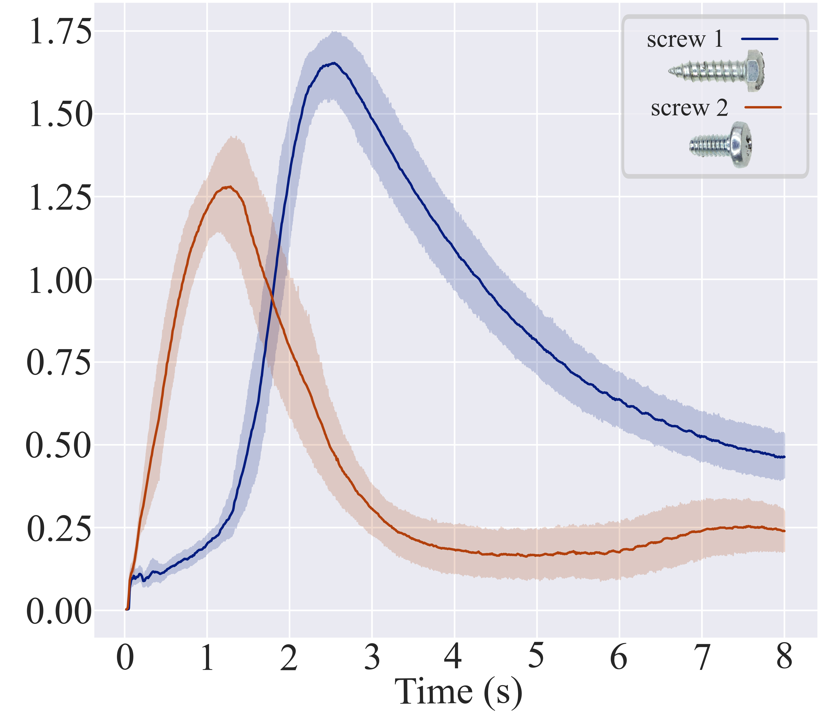
static/images/r5.jpg
