anonymrobotic/artis/static/images/r6.jpg

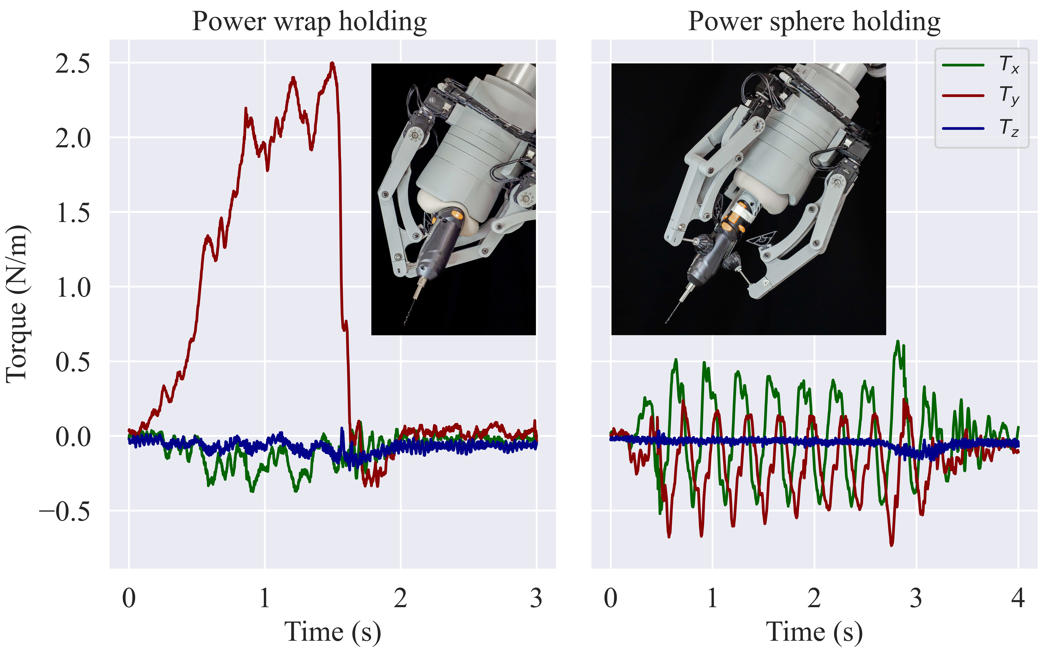
static/images/r6.jpg
