anonymrobotic/artis/static/images/rob_1.jpg

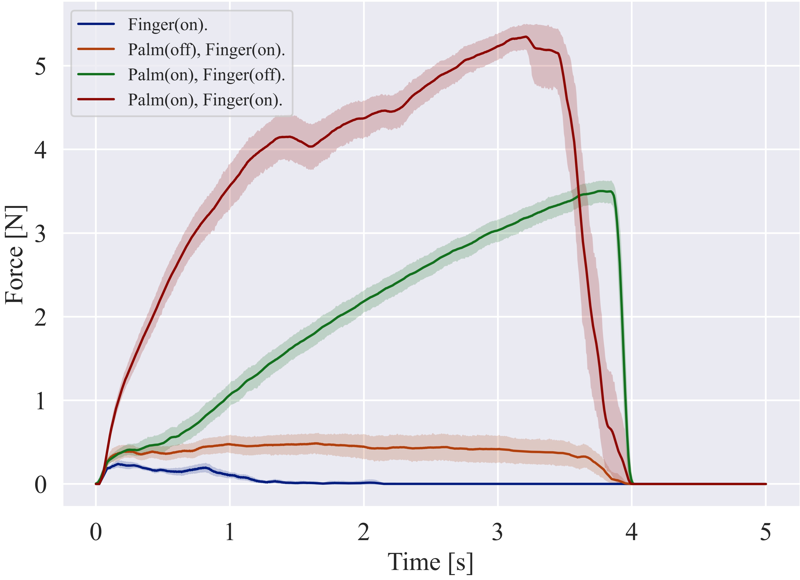
static/images/rob_1.jpg
