anonymrobotic/artis/static/images/rob_2.jpg

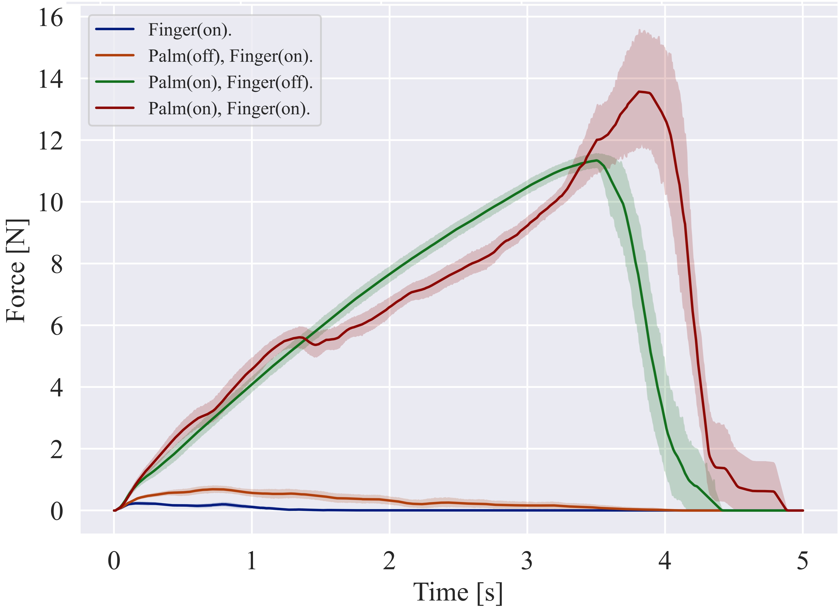
static/images/rob_2.jpg
