anonymrobotic/artis/static/images/rob_3.jpg

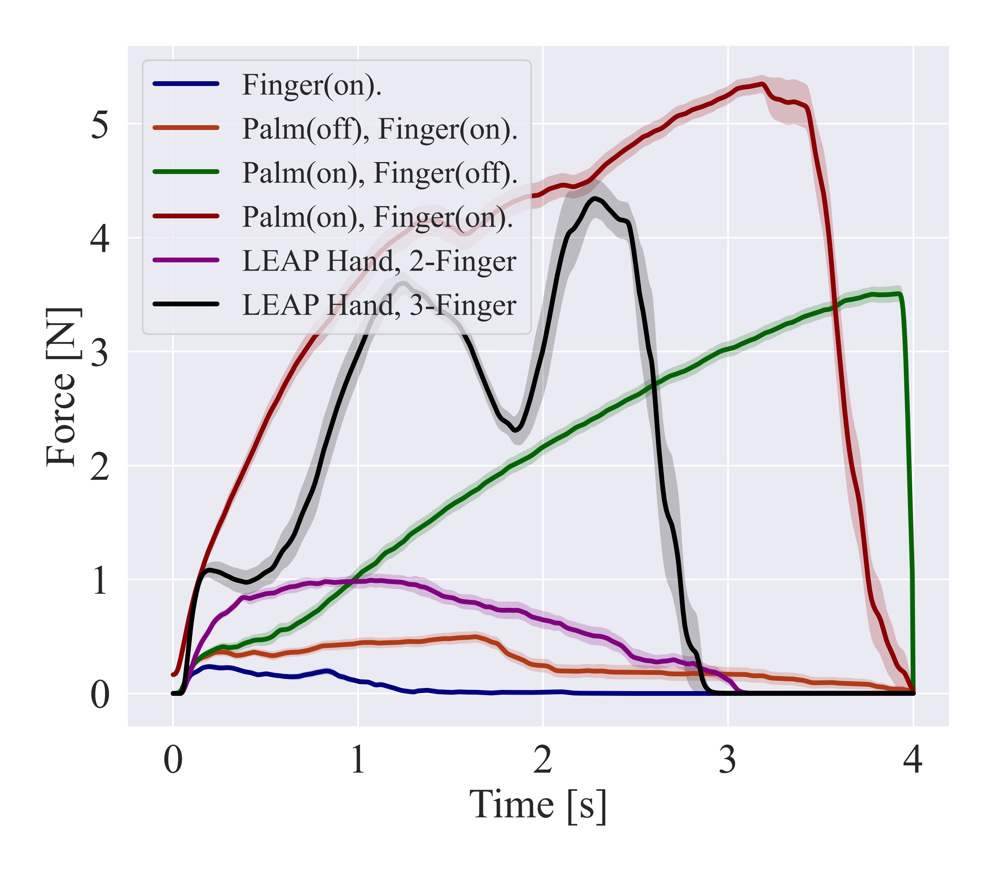
static/images/rob_3.jpg
