anonymrobotic/artis/static/images/rob_4.jpg

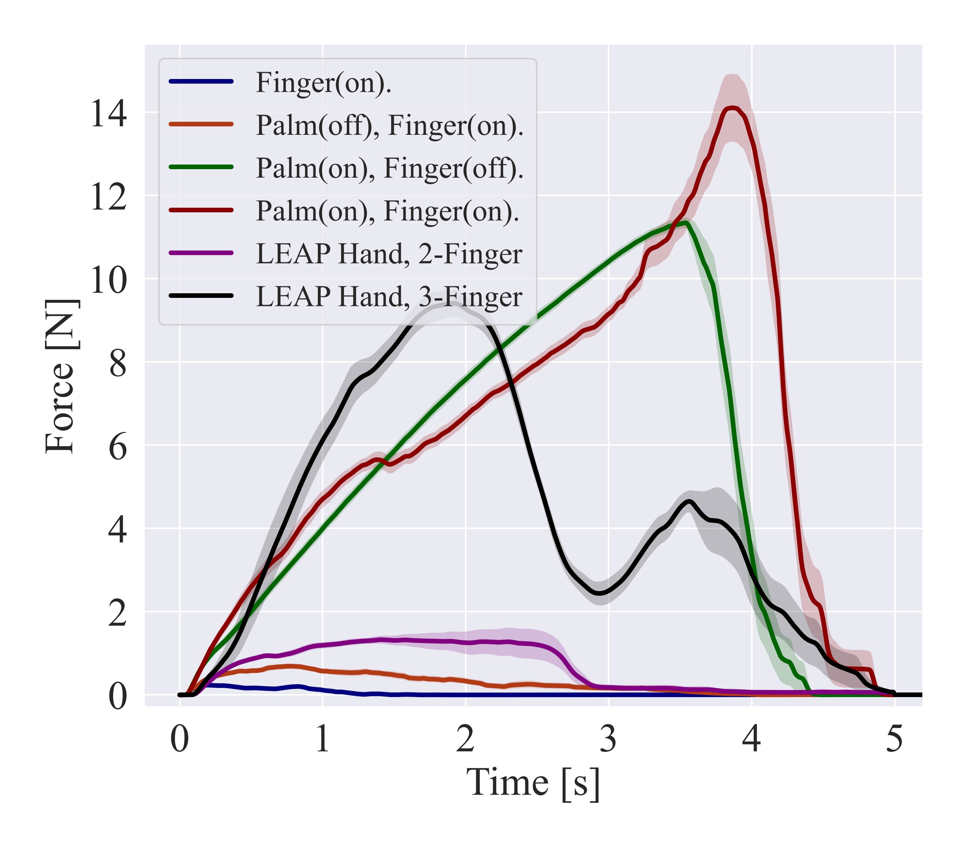
static/images/rob_4.jpg
