anonymrobotic/artis/static/images/rob_23.jpg

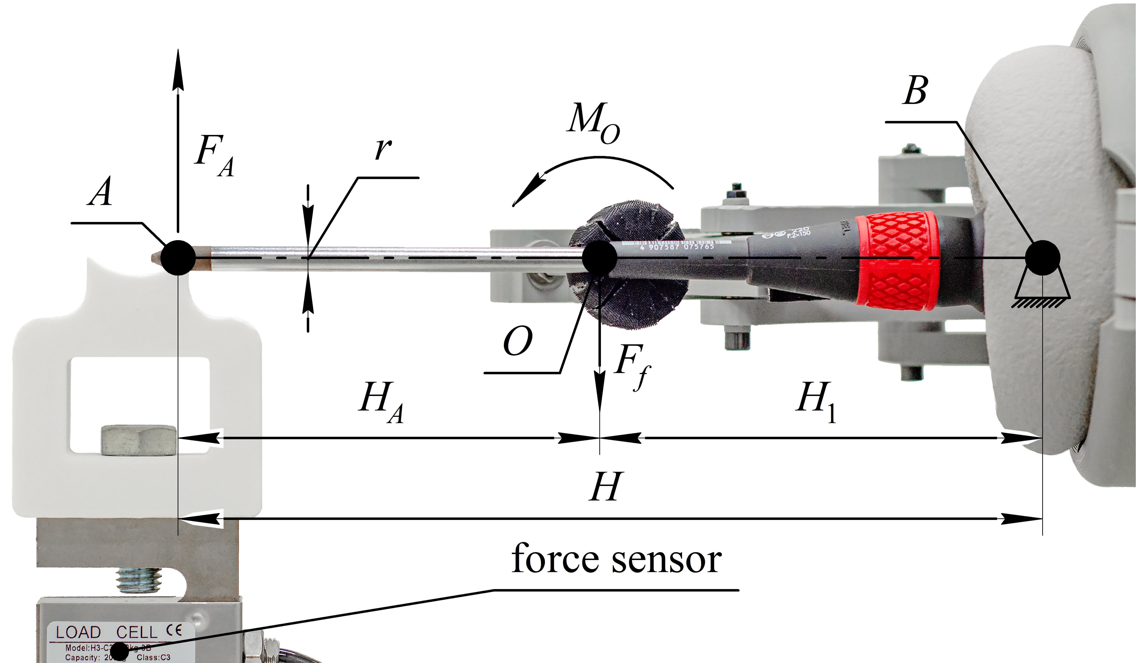
static/images/rob_23.jpg
