anonymrobotic/artis/static/images/Score.jpg

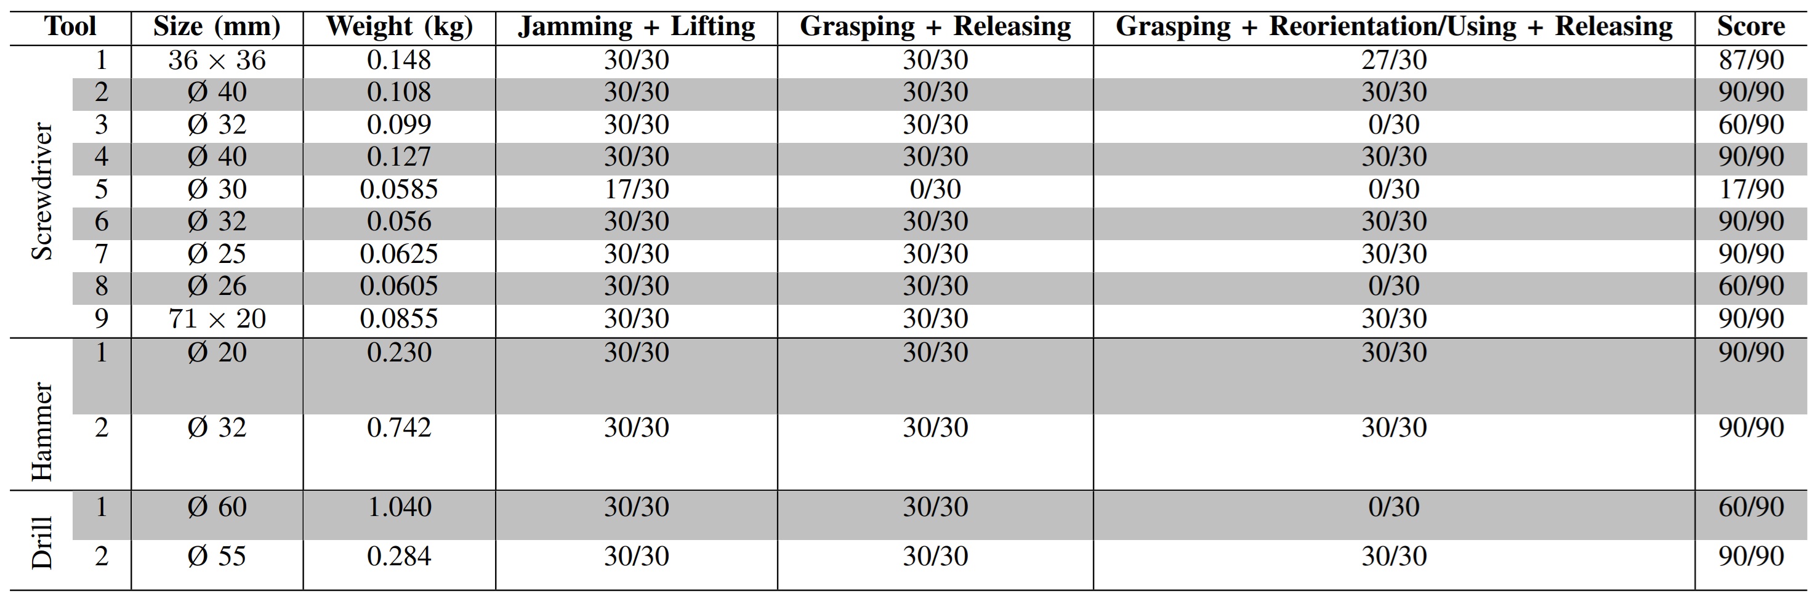
static/images/Score.jpg
