anonymrobotic/artis/static/images/SD_1.jpg

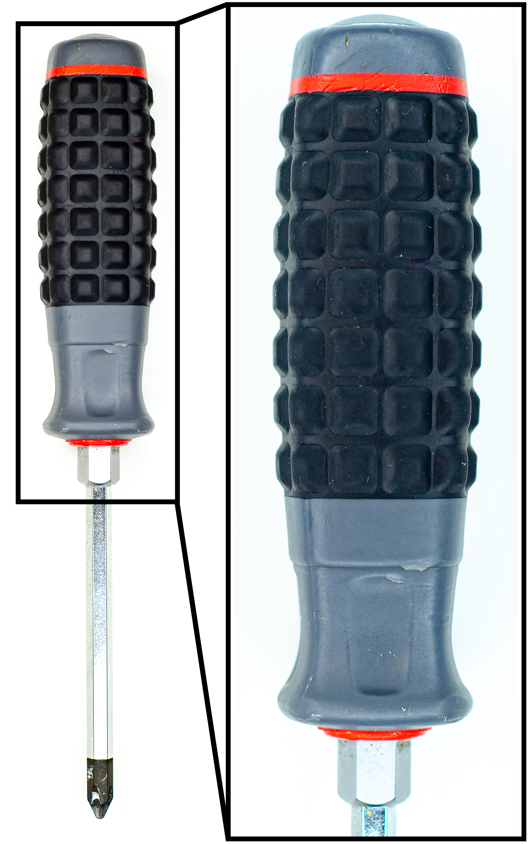
static/images/SD_1.jpg
