anonymrobotic/artis/static/images/SD_2.jpg

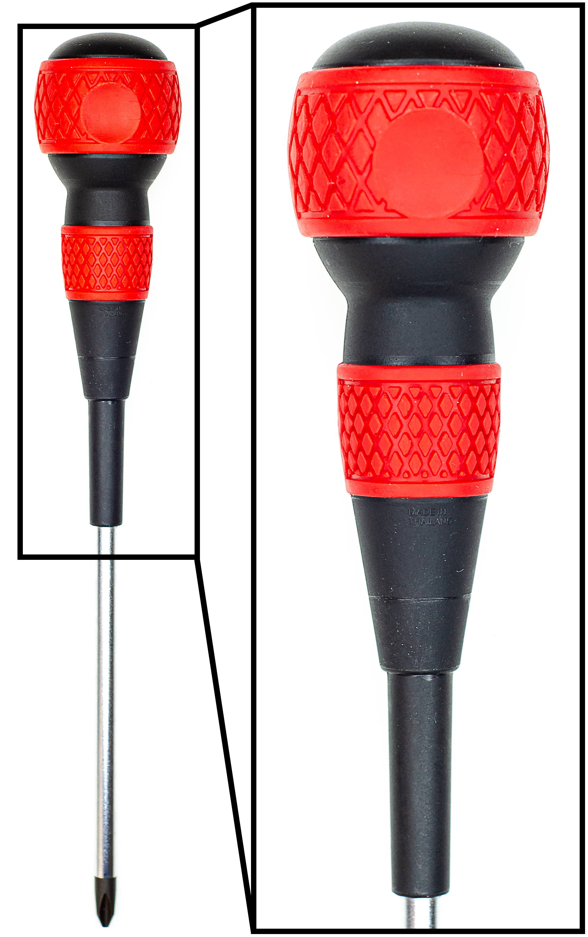
static/images/SD_2.jpg
