anonymrobotic/artis/static/images/SD_4.jpg

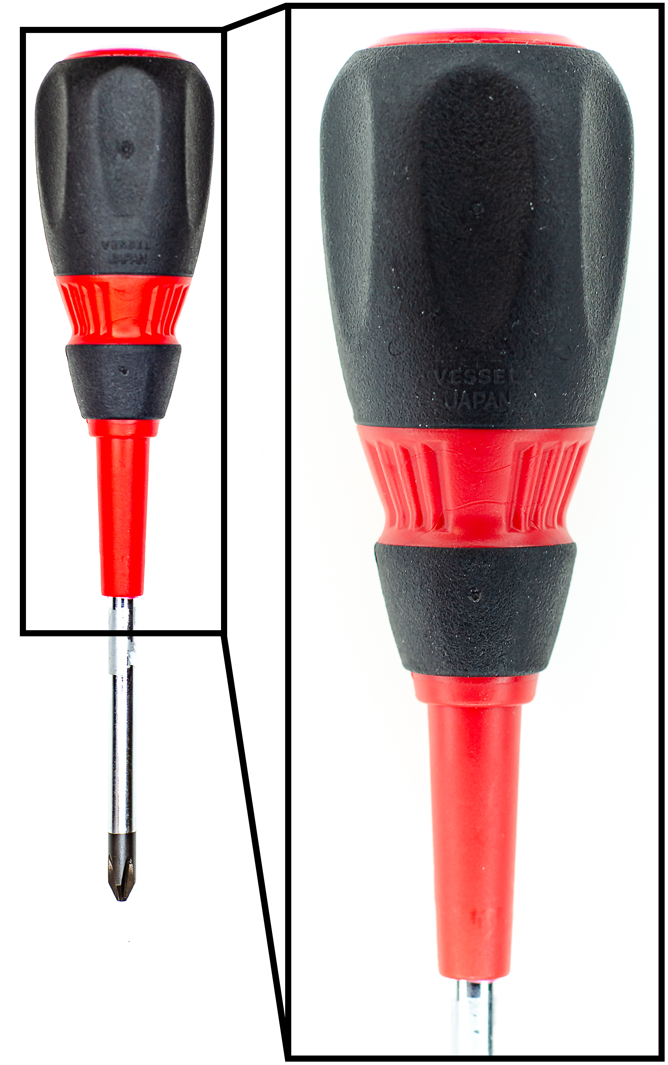
static/images/SD_4.jpg
