anonymrobotic/artis/static/images/SD_5_1.jpg

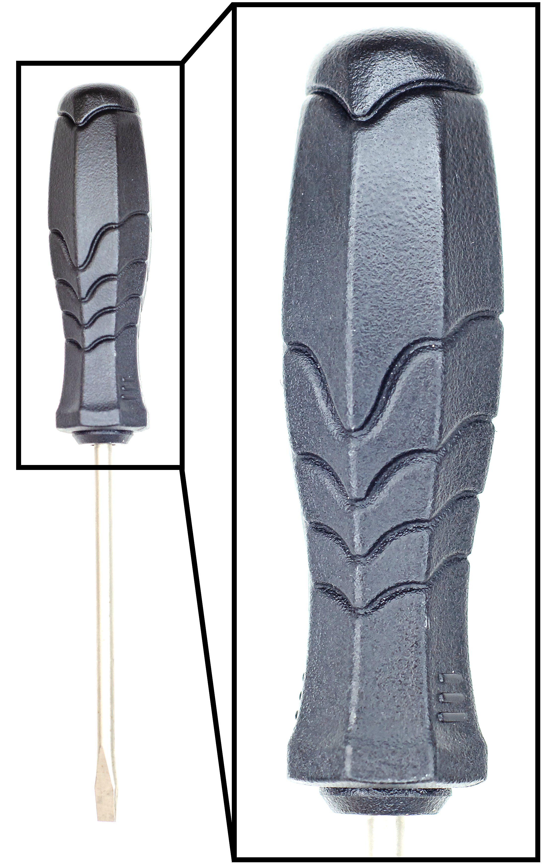
static/images/SD_5_1.jpg
