anonymrobotic/artis/static/images/SD_7.jpg

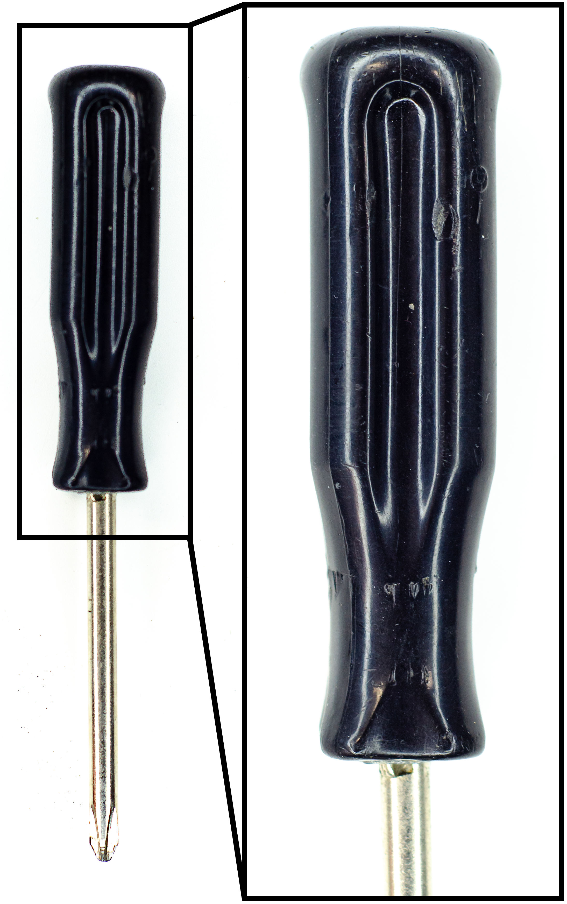
static/images/SD_7.jpg
