anonymrobotic/artis/static/images/SD_9.jpg

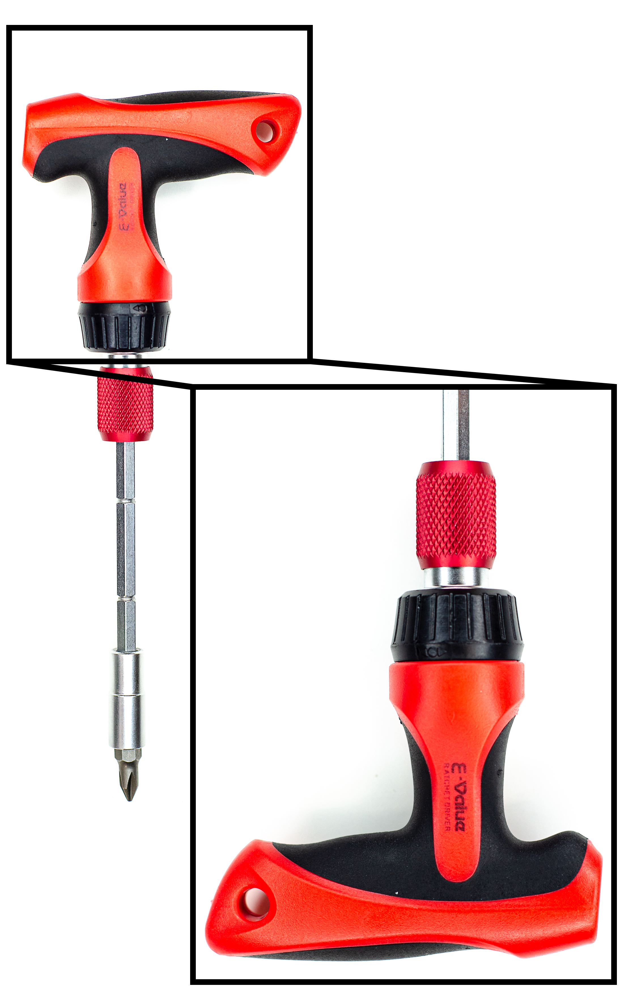
static/images/SD_9.jpg
