anonymrobotic/artis/static/images/spec.jpg

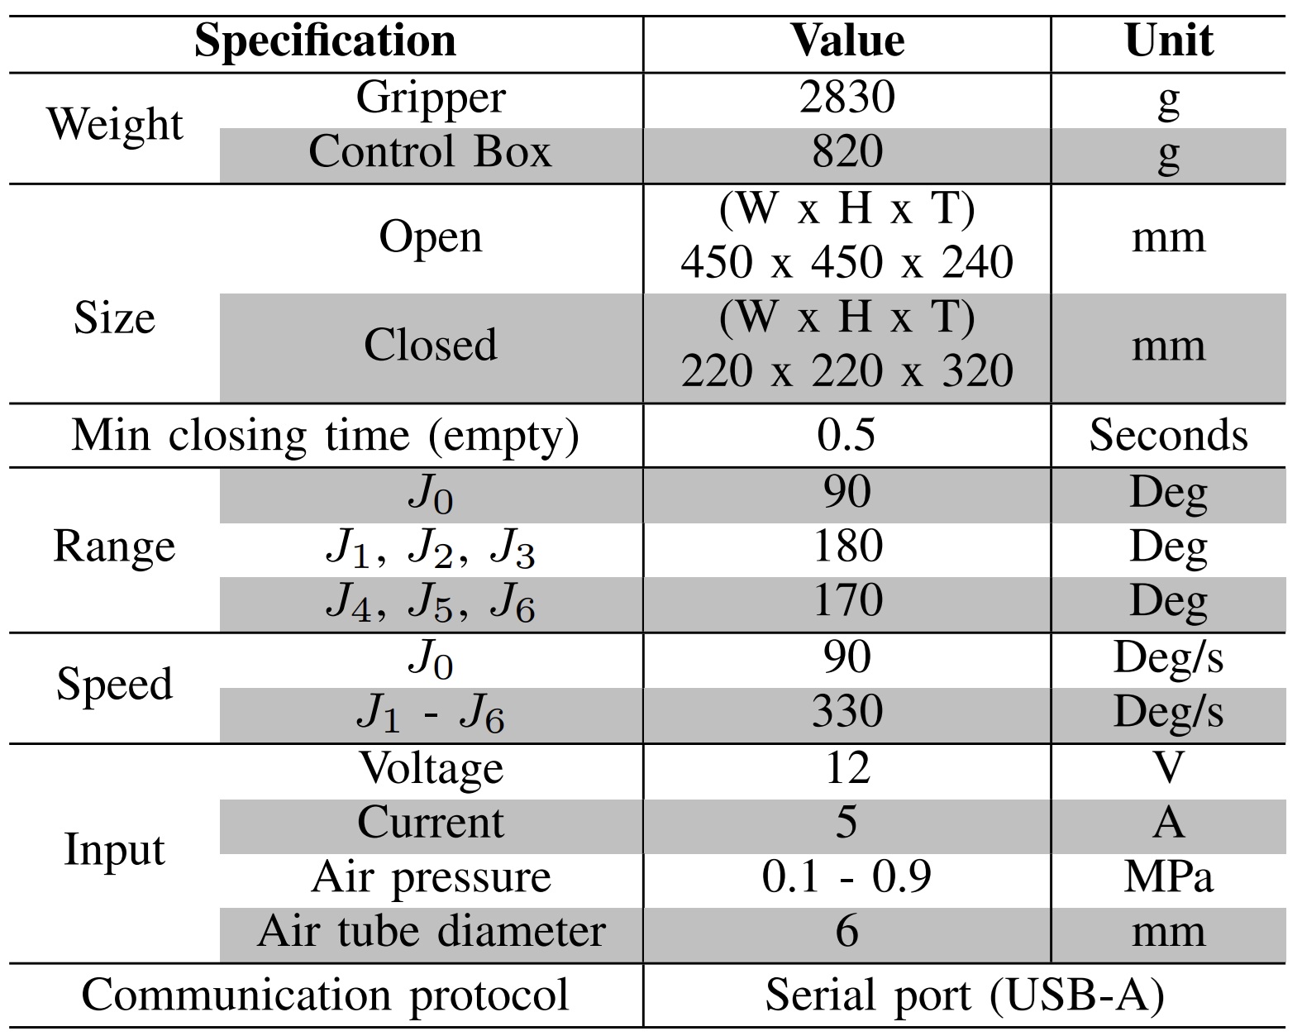
static/images/spec.jpg
