anonymrobotic/artis/static/images/spec_ej.png

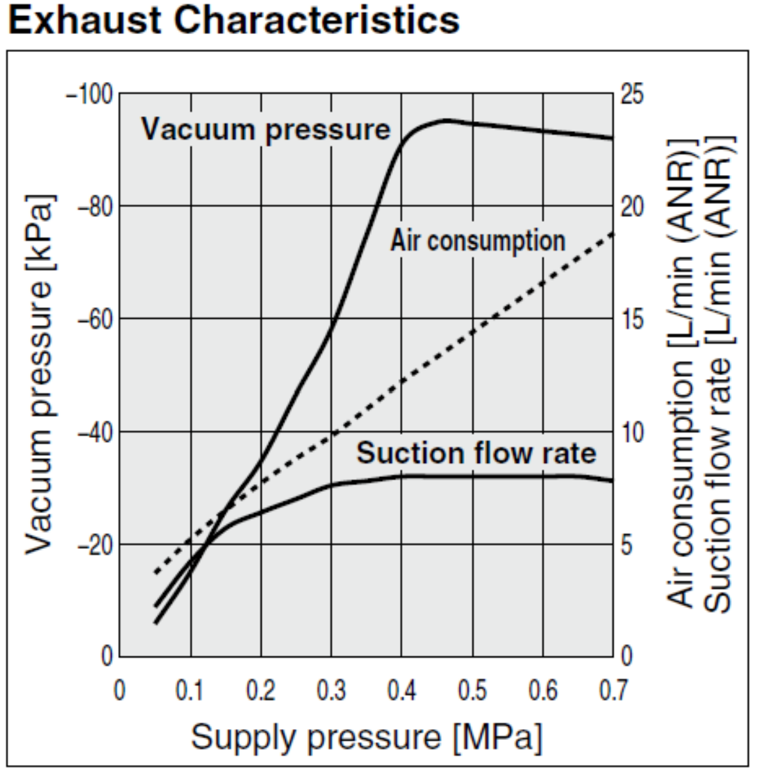
static/images/spec_ej.png
