anonymrobotic/artis/static/images/stat1.jpg

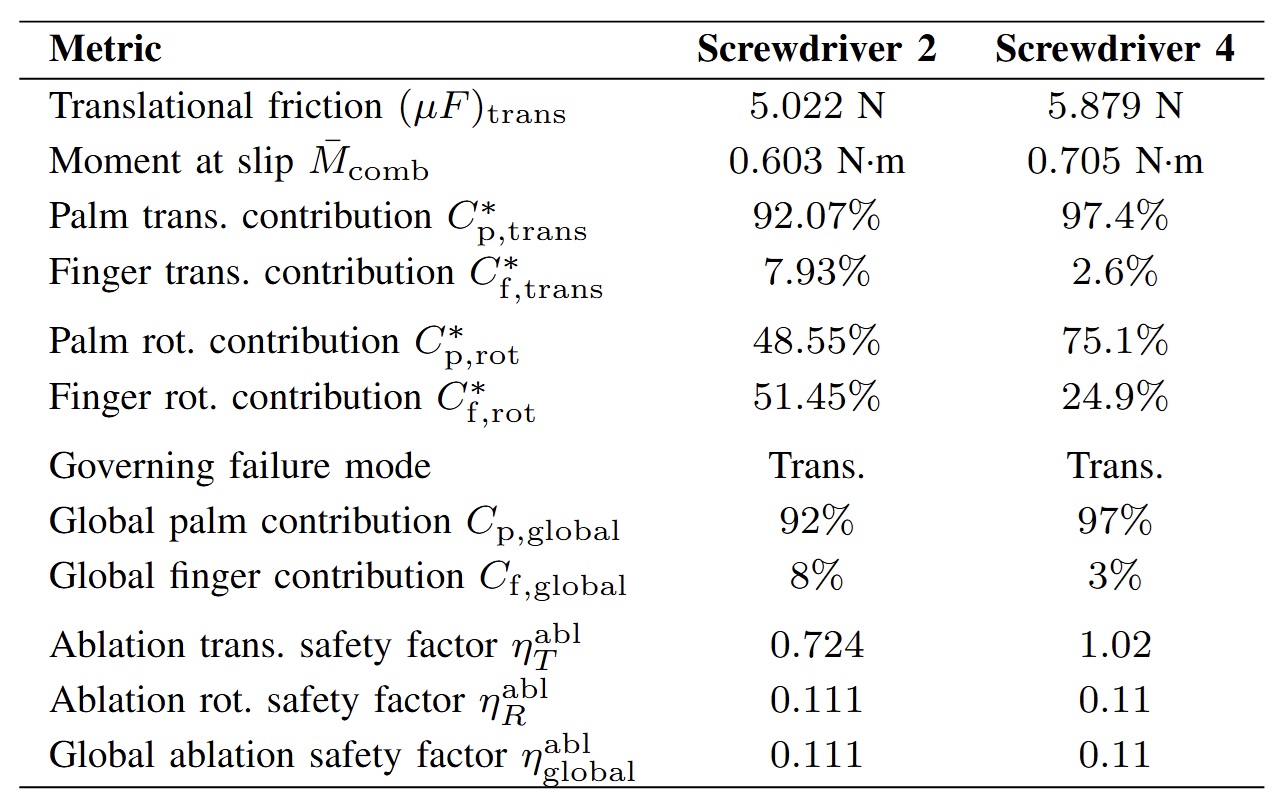
static/images/stat1.jpg
