anonymrobotic/artis/static/images/stat2.jpg

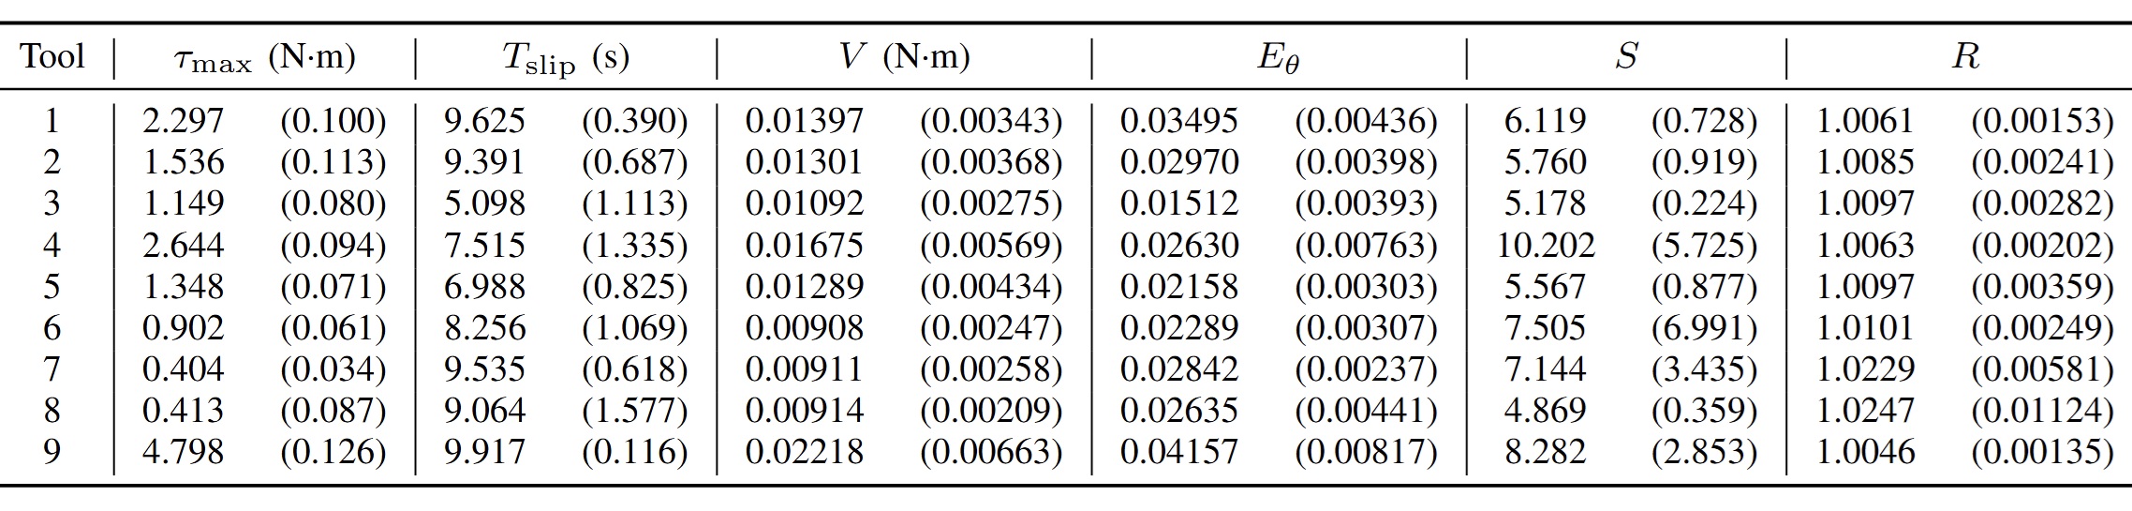
static/images/stat2.jpg
