anonymrobotic/artis/static/images/CAD/Electrical_Components_Holder.jpg

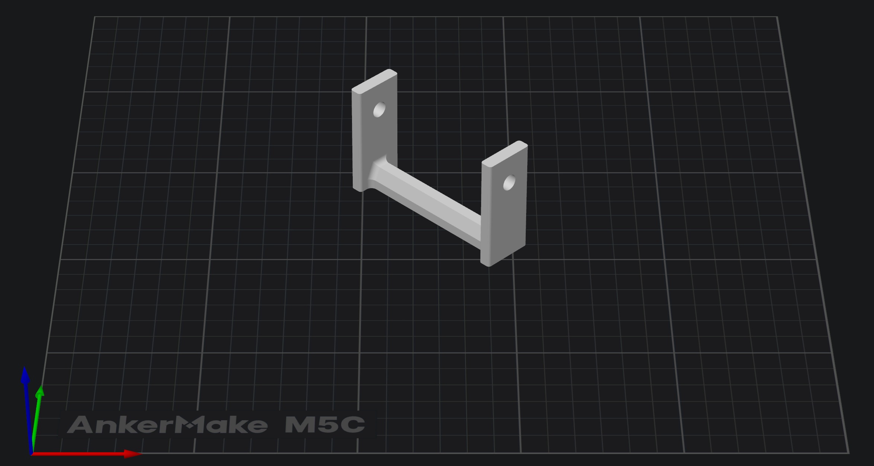
static/images/CAD/Electrical_Components_Holder.jpg
