anonymrobotic/artis/static/code/artis_gripper/presets.py

from __future__ import annotations

from typing import Dict

# Converted directly from the uploaded experimental keyboard-control script.
# Keys are kept for compatibility during migration.
LEGACY_PRESETS: Dict[str, Dict[int, tuple[int, int]]] = {
    'a': {2: (2052, 80), 3: (3630, 60), 4: (2052, 80), 5: (3630, 60), 6: (2052, 80), 7: (3630, 60), 8: (60, 80)},
    's': {2: (2052, 80), 3: (3630, 60), 4: (2052, 80), 5: (1330, 60), 6: (2052, 80), 7: (1330, 60), 8: (60, 80)},
    'd': {2: (2052, 80), 3: (3630, 60), 4: (2002, 80), 5: (1330, 60), 6: (2102, 80), 7: (1330, 60), 8: (60, 80)},
    'f': {2: (2052, 80), 3: (3630, 60), 4: (2102, 80), 5: (1330, 60), 6: (2002, 80), 7: (1330, 60), 8: (60, 80)},
    'z': {2: (2052, 80), 3: (3630, 60), 4: (2052, 80), 5: (3630, 60), 6: (2052, 80), 7: (3630, 60), 8: (1712, 80)},
    'x': {2: (2052, 80), 3: (1330, 85), 4: (2052, 80), 5: (1330, 87), 6: (2052, 80), 7: (1330, 90), 8: (1712, 80)},
    'c': {2: (2052, 80), 3: (3630, 60), 4: (2052, 80), 5: (3630, 60), 6: (2052, 80), 7: (3630, 60), 8: (3500, 80)},
    'b': {2: (2052, 80), 3: (3630, 60), 4: (2320, 80), 5: (3630, 60), 6: (1784, 80), 7: (3630, 60), 8: (3500, 80)},
    'n': {2: (2052, 80), 3: (1130, 60), 4: (2320, 80), 5: (1130, 60), 6: (1784, 80), 7: (1130, 60), 8: (3500, 80)},
    'm': {2: (2052, 80), 3: (1130, 60), 4: (2320, 80), 5: (1130, 60), 6: (1784, 80), 7: (3630, 60), 8: (3500, 80)},
}
