anonymrobotic/artis/static/images/Fig_4_1_6.jpg

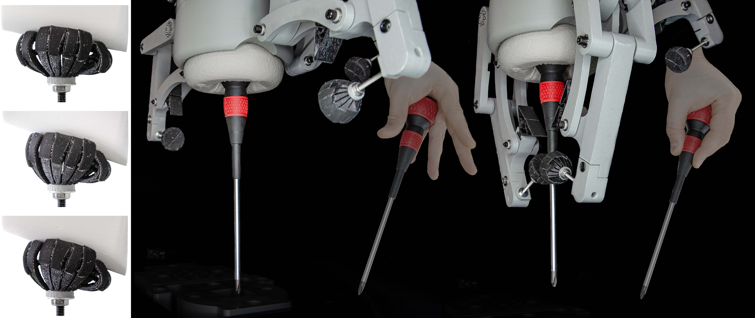
static/images/Fig_4_1_6.jpg
