anonymrobotic/artis/static/images/teching_2.jpg

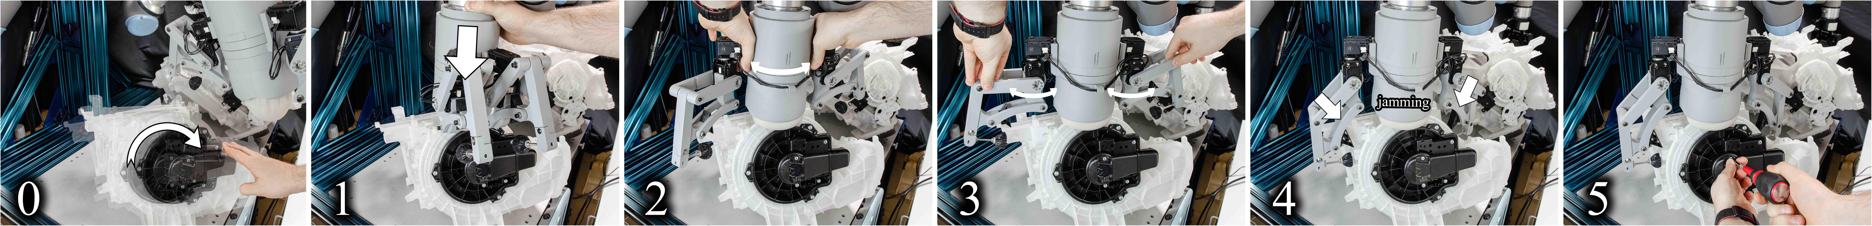
static/images/teching_2.jpg
