anonymrobotic/artis/static/images/Setup_2.jpg

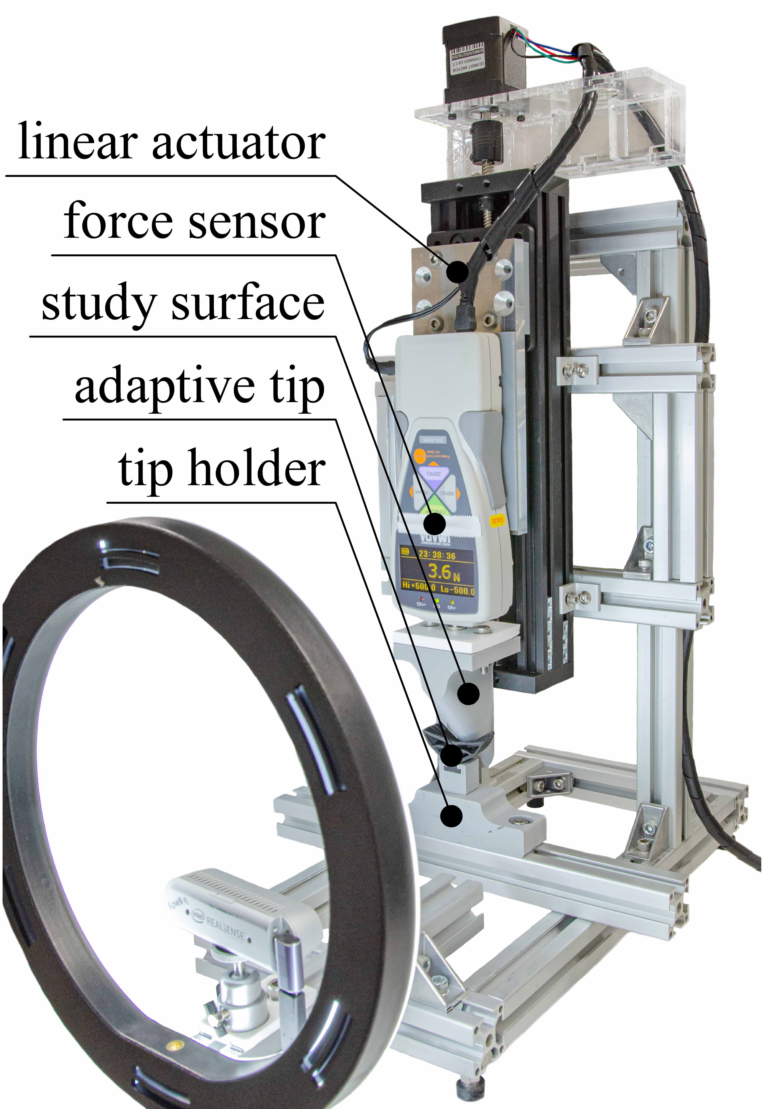
static/images/Setup_2.jpg
